Allen953/Baize_Q1mini/6.Education Files&PPT/PPT/6.IR RGB.pptx

## 机器人与人工智能实验室 Robotics and Artificial Intelligence Laboratory

Exciting Projects in RAIL CUHK-SZ

WELCOME TO

## RGB IR Controlling

- Change the three primary colours of the RBG light through the three buttons 1, 2, and 3 of the remote control, and press any other button to turn off the light.

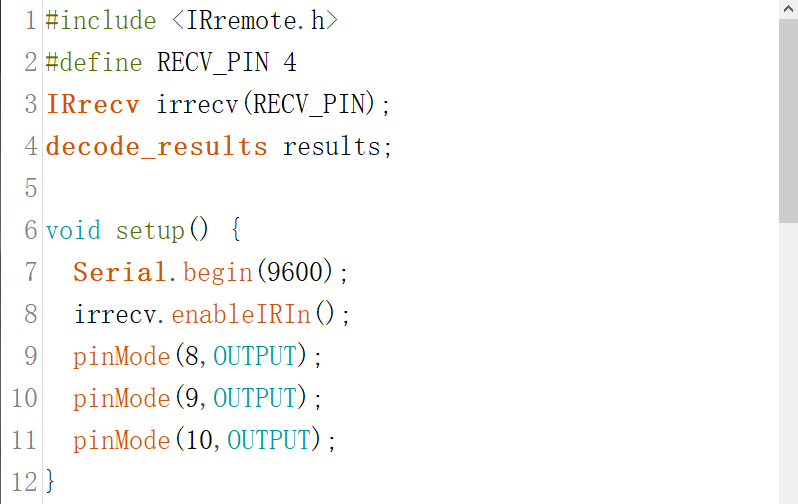
[picture p36: figure]

## RGB IR Controlling

- Next:

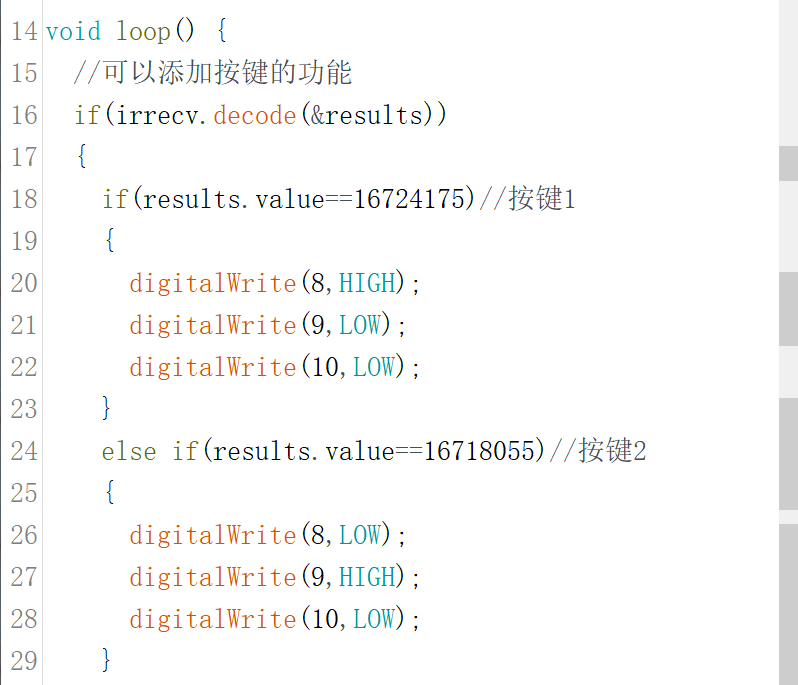
[picture p37: figure]

## RGB IR Controlling

- Next:

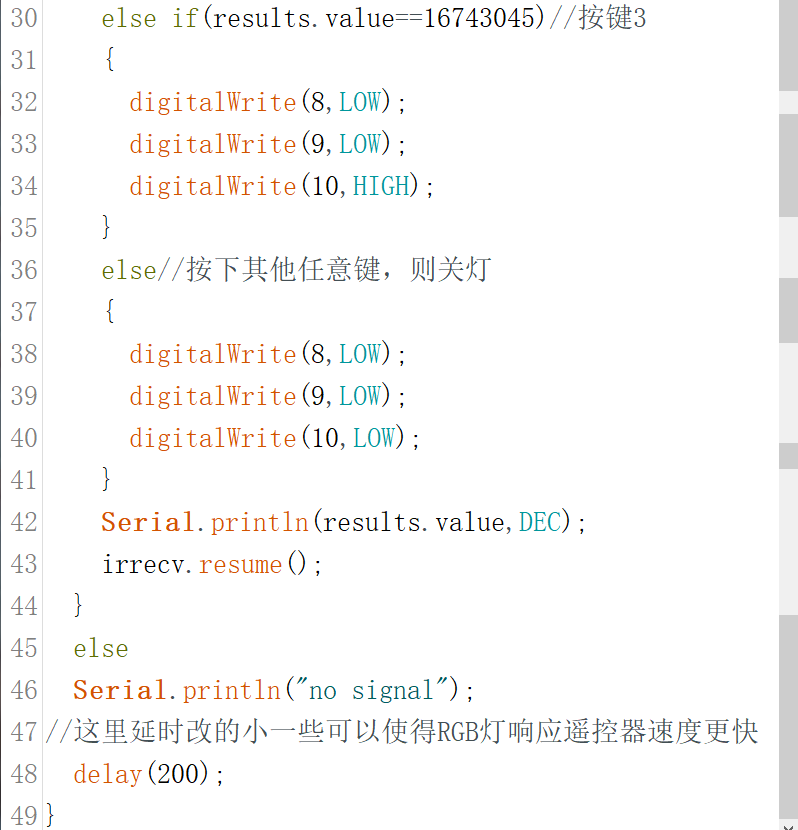
[picture p38: figure]

## THANK YOU

Teaching Building

- 林天麟 教授
- 香港中文大学（深圳）
- 机器人与人工智能实验室
- WeChat: tinlunlam
