Allen953/Baize_Q1mini/6.Education Files&PPT/PPT/AddNew.pptx

## 机器人与人工智能实验室 Robotics and Artificial Intelligence Laboratory

Exciting Projects in RAIL CUHK-SZ

WELCOME TO

## Adding New Instincts

- 1. Introduction
- Skills are the right fit between each steering engines.
- Skills can be divided into gait and posture according to the frame numbers, and the program also divides the skills into instinct (I) and new-skill (n).
- New-skills can be used as a test. When a new-skill is tested to be mature, it can be converted into a instinct.

## Adding New Instincts

- 2. Try to add a new posture called outstretch.
- 1. Code as the followings in instinct.h.
- 2. Add the name and type of the new skill.

## Adding New Instincts

- 3. Modify the skill number.
- 4. If the new skill performs well, it can be stored as a instinct (I) to reduce memory usage.

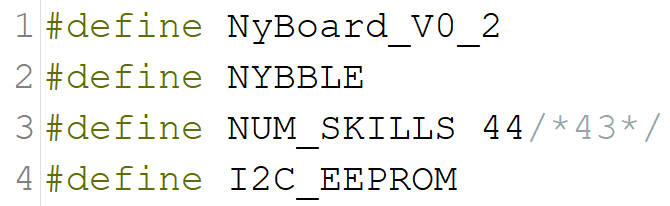
[picture p59: figure]

## THANK YOU

Teaching Building

- 林天麟 教授
- 香港中文大学（深圳）
- 机器人与人工智能实验室
- WeChat: tinlunlam
