Allen953/Baize_Q1mini/6.Education Files&PPT/PPT/Bluetooth.pptx

## 机器人与人工智能实验室 Robotics and Artificial Intelligence Laboratory

Exciting Projects in RAIL CUHK-SZ

WELCOME TO

## Control via Bluetooth

- 1. Preparation
- The Bluetooth module HC-05.
- The LED indicates the Bluetooth connection status:
- A fast flash----------No Bluetooth connection
- A slow flash---------The AT mode
- A double flash------Bluetooth connected and port opened

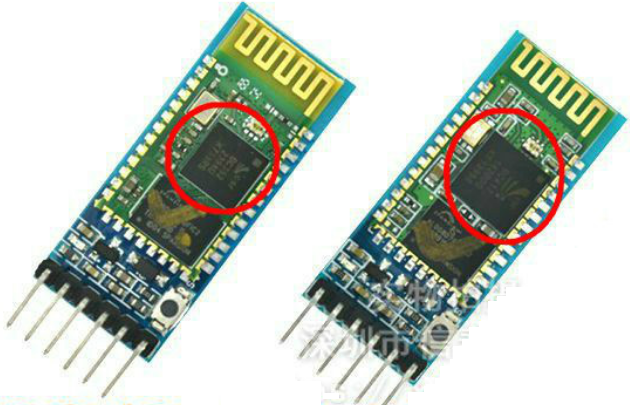
[picture p60: figure]

## Control via Bluetooth

- 2. Debugging
- AT mode (Next Slide)
- Serial port tool

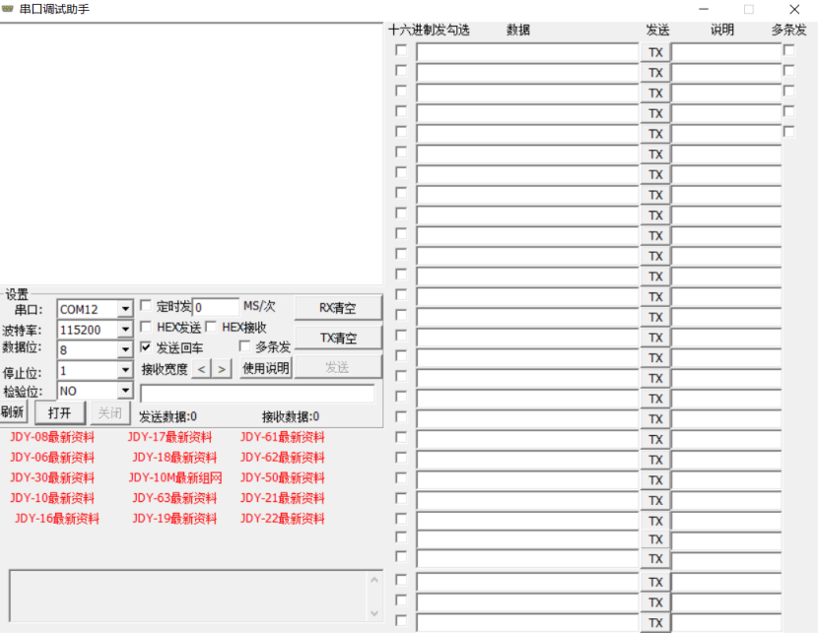
[picture p61: figure]
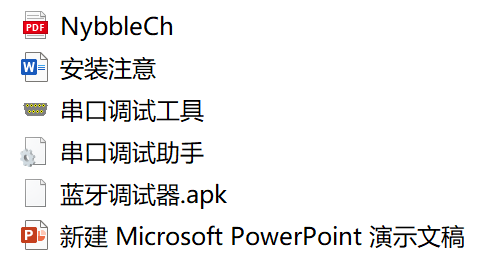
[picture p62: figure]

## Control via Bluetooth

- 3. Setting for AT Mode
- 1. Connect the FTDI downloader to the HC-05 module with a DuPont cable with bus-connectors on both sides.

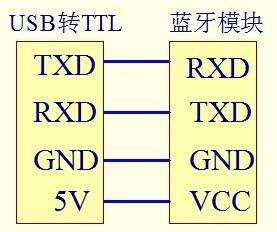
[picture p63: figure]

## Control via Bluetooth

- 2. Press and hold the black button on the module, and then power on, you can enter the AT mode.

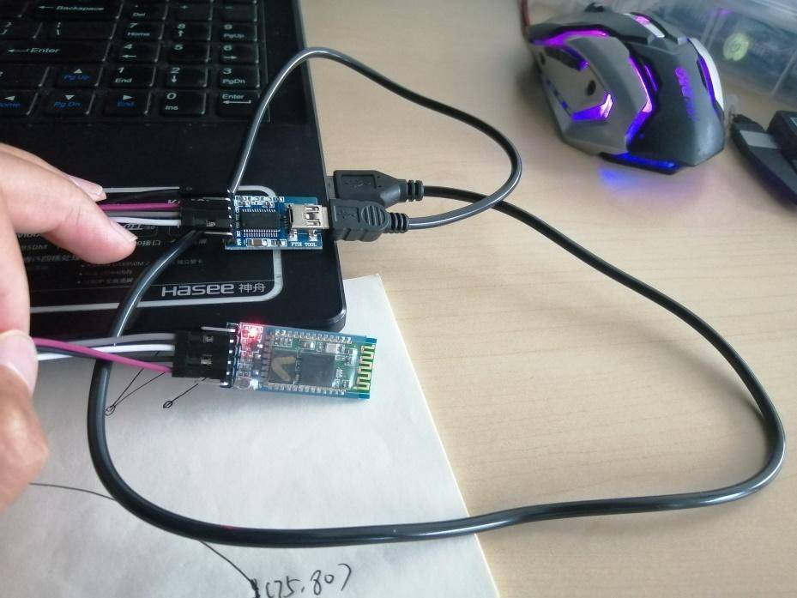
[picture p64: figure]

## Control via Bluetooth

- 3. Find the device manager to see which port Bluetooth is currently on.

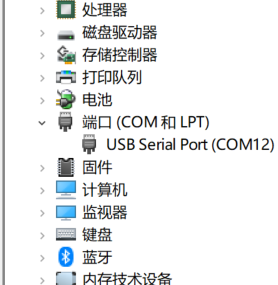
[picture p65: figure]

## Control via Bluetooth

- 4. Open the software and set as follows:
- (a) The baud rate (Customizable): 38400
- (b) Serial port: COM12
- (c) Check "Send Enter"
- Then click the "Open" button.
- Type in "AT" and the window returns OK. This shows that we have successfully entered the AT mode.

## Control via Bluetooth

- 5. Enter the following commands successively. For each line of instructions, click Send.
- (a) AT+NAME=Opencat9
- (b) AT+UART=57600,0,0
- (c) AT+ROLE=0
- Every time a command is sent, it will return OK if setting successfully. We can see that a total of three OK are returned, indicating that all settings are valid.

## Control via Bluetooth

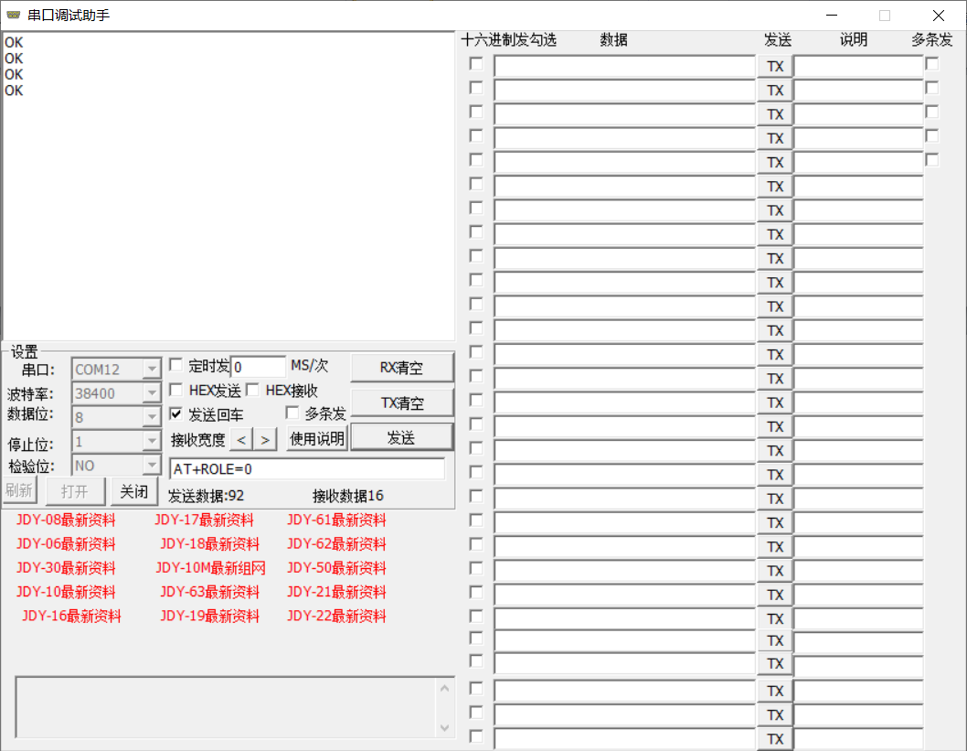
[picture p66: figure]

## Control via Bluetooth

- 4. Bluetooth Connecting
- 1. Installing Bluetooth Debugger
- P.S. APK provided:

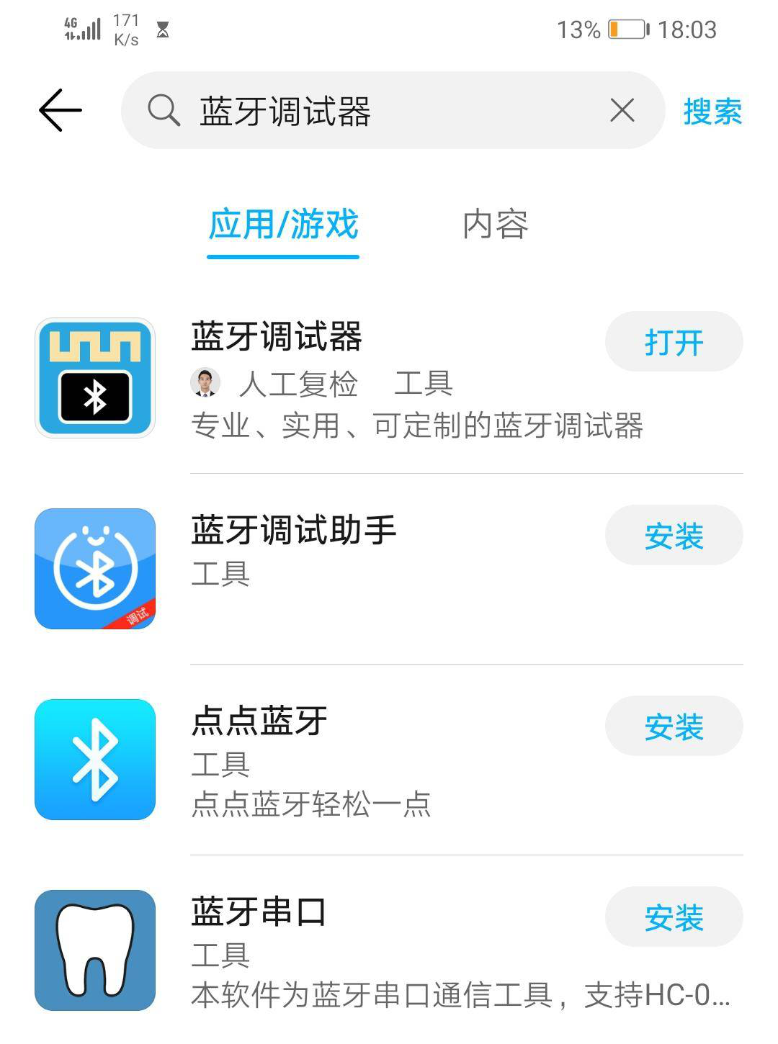
[picture p67: figure]
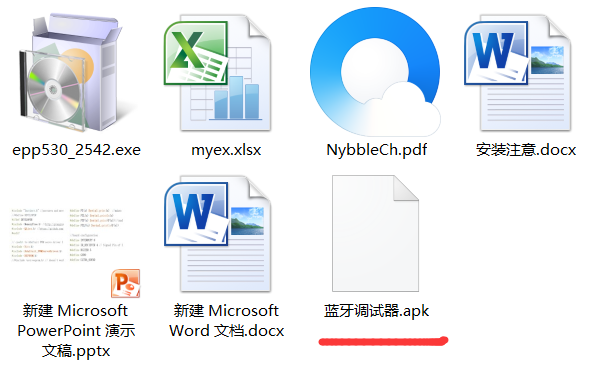
[picture p68: figure]

## Control via Bluetooth

- 2. Connecting with the APP
- Connect targets
- Scan available devices

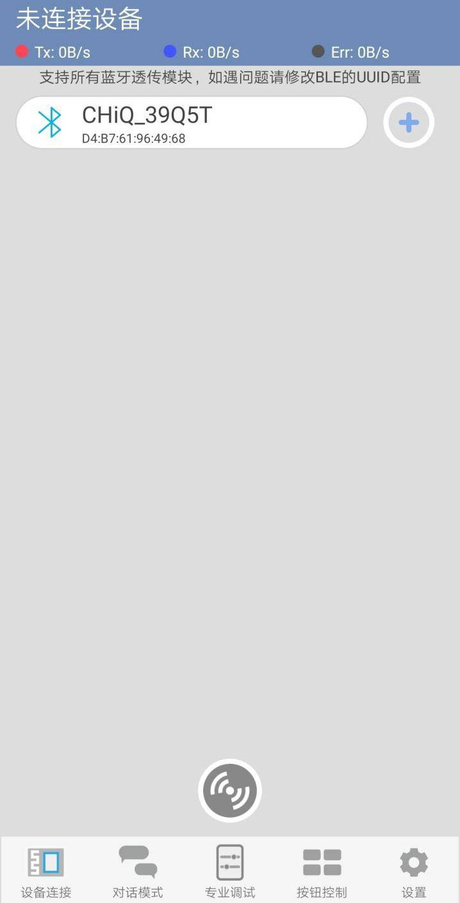
[picture p69: figure]

## Control via Bluetooth

- 3. Edit commands
- Detail:

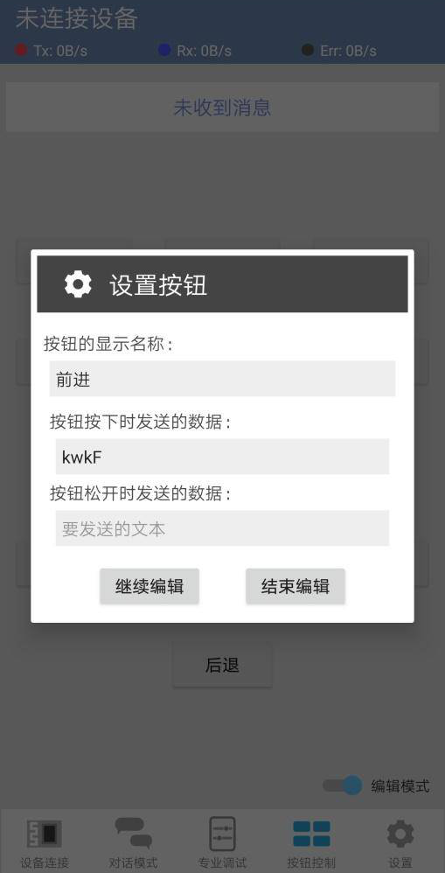
[picture p70: figure]
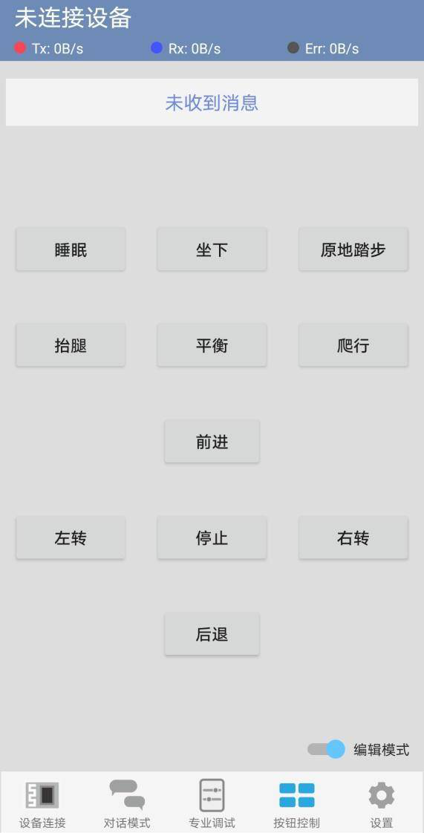
[picture p71: figure]

krest or d - Stopping steering engine
kbalance - Standing still
kwk - Walking forward
kwkL - Turning left
kwkR - Turning right
kbk - Retreating
ksleep - Sleeping
ksit - Sitting down
kvt - Stepping on the same spot
kpee - Peeing
Kcr - Crawling

## THANK YOU

Teaching Building

- 林天麟 教授
- 香港中文大学（深圳）
- 机器人与人工智能实验室
- WeChat: tinlunlam
