Allen953/Baize_Q1mini/1.3D model/Baize_QuadrupedRobot_3.0/readme.txt

板厚:3.0毫米
有激光切割零件，也有3D打印零件
所用的开发板底板为淘宝购买nano扩展板
