Allen953/Baize_Q1mini/1.3D model/Baize_QuadrupedRobot_Allboard/readme.txt

板厚:3.0毫米
全部零件都是板件切割
开发板底板用的是淘宝购买的nano扩展板
