Allen953/Baize_Q1mini/6.Education Files&PPT/PPT/Software.pptx

## 机器人与人工智能实验室 Robotics and Artificial Intelligence Laboratory

Exciting Projects in RAIL CUHK-SZ

WELCOME TO

## Tips on the Software

- 1. The Serial Monitor

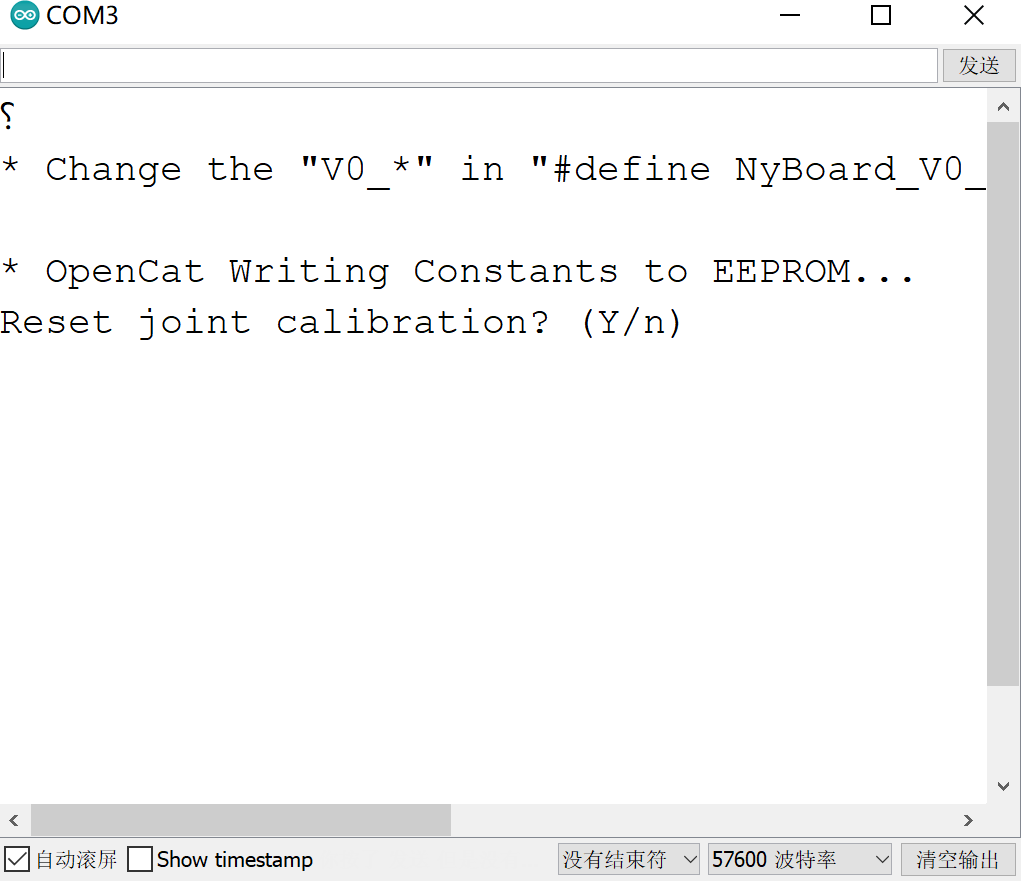
[picture p72: figure]

Significant for updating instincts of the cat!

Choose “No Line Ending” but Not “New Line”

## Tips on the Software

- The Serial Monitor

Only if No Line Ending is selected will the window shows the prompt for updating instincts.

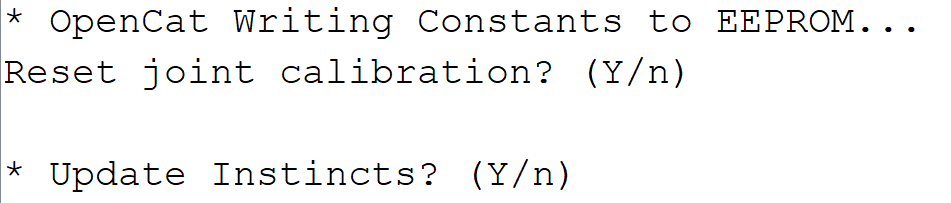
[picture p73: figure]

## THANK YOU

Teaching Building

- 林天麟 教授
- 香港中文大学（深圳）
- 机器人与人工智能实验室
- WeChat: tinlunlam
