Allen953/Baize_Q1mini/2.Hard ware(EasyEDA)/电路板文件/PCB_PCB_New Projec_2021-09-20.png

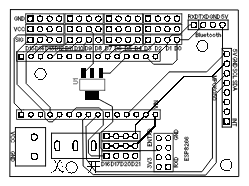
2.Hard ware(EasyEDA)/电路板文件/PCB_PCB_New Projec_2021-09-20.png
