Allen953/Baize_Q1mini/1.3D model/Baize_QuadrupedRobot_2.8/solidworks2020/MINIUSB - MEASURED.SLDASM

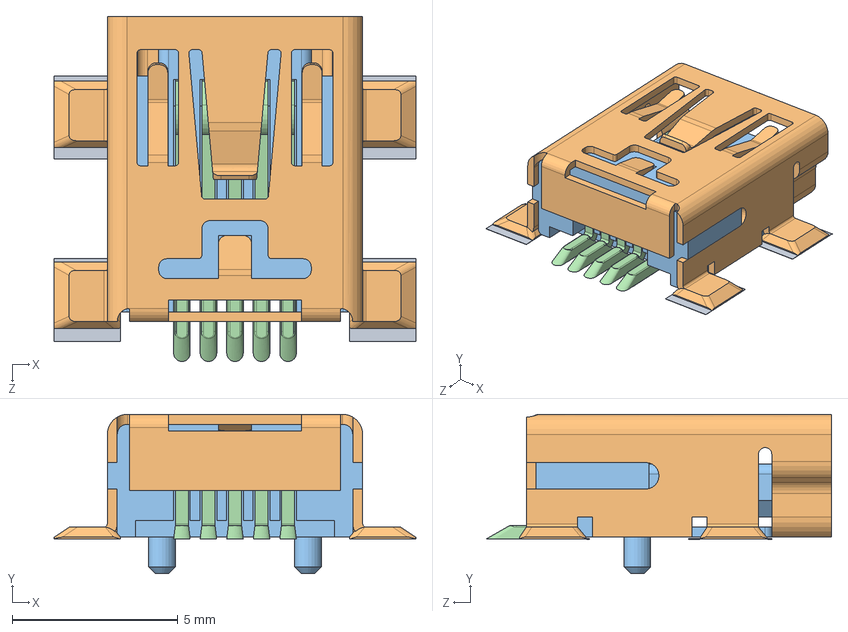
[picture p75: CAD file, 2022-08-04]
1.3D model/Baize_QuadrupedRobot_2.8/solidworks2020/MINIUSB - MEASURED.SLDASM
10.9 x 4.80 x 10.4 mm
MINIUSBSHELL
MINIUSBCORE
MINI USB CONTACT x 5
MINI USB SOLDER
