Allen953/Baize_Q1mini/1.3D model/Baize_QuadrupedRobot_2.8/solidworks2020/User Library-PJ-002AH.sldasm

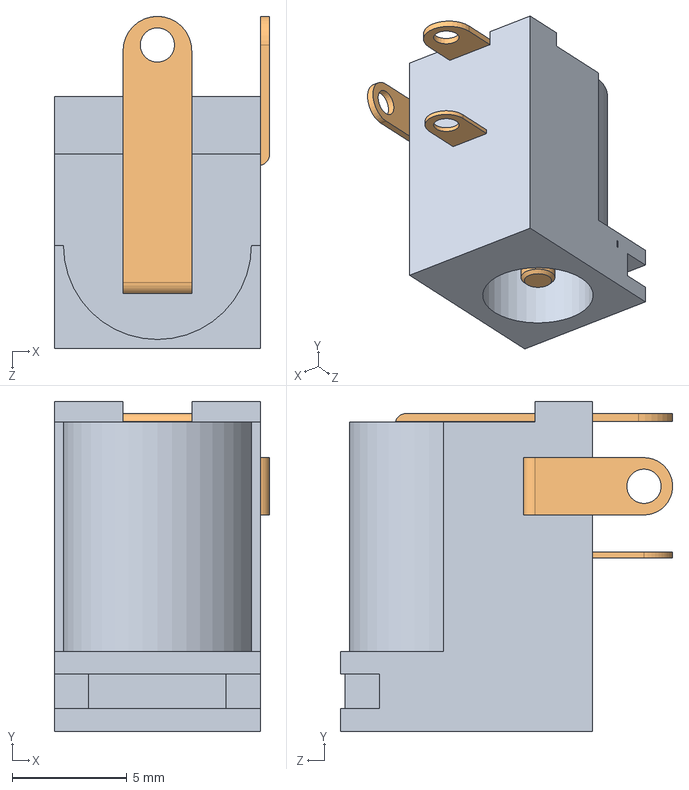
[picture p76: CAD file, 2022-08-04]
1.3D model/Baize_QuadrupedRobot_2.8/solidworks2020/User Library-PJ-002AH.sldasm
9.40 x 14.4 x 14.5 mm
User Library-PJ-002AH_Body
User Library-PJ-002AH_Pad
