Allen953/Baize_Q1mini/1.3D model/Baize_QuadrupedRobot_2.8/solidworks2020/SG90 - Micro Servo 9g - Tower Pro.SLDASM

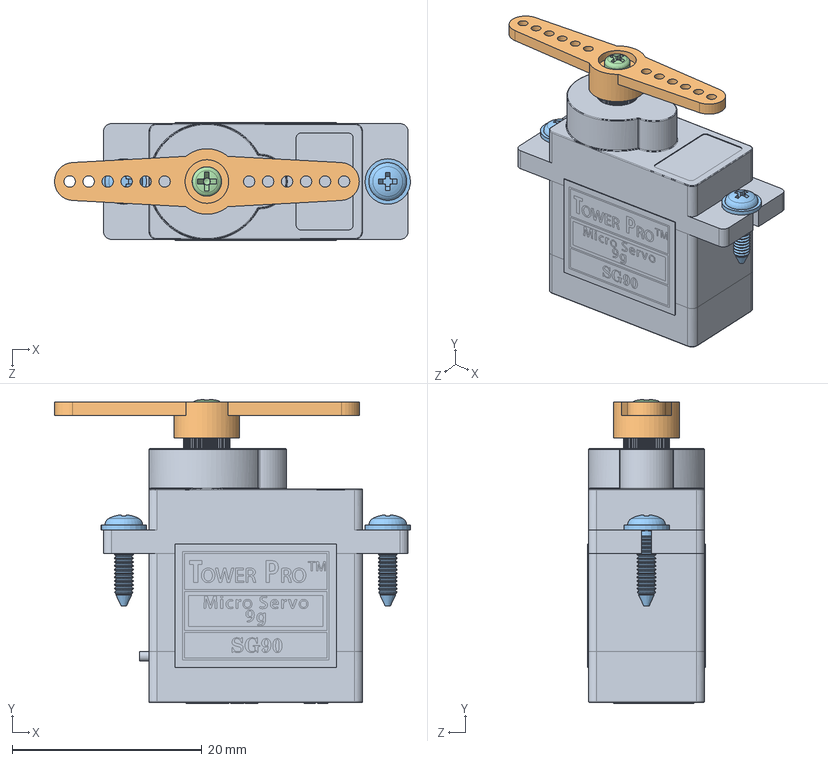
[picture p77: CAD file, 2022-08-04]
1.3D model/Baize_QuadrupedRobot_2.8/solidworks2020/SG90 - Micro Servo 9g - Tower Pro.SLDASM
37.5 x 32.0 x 12.4 mm
SG90 - Micro Servo 9g - Tower Pro.1
SG90 - Micro Servo 9g - Tower Pro.3
SG90 - Micro Servo 9g - Tower Pro.5 x 2
SG90 - Micro Servo 9g - Tower Pro.6
