Allen953/Baize_Q1mini/1.3D model/Baize_QuadrupedRobot_Allboard/Gou-2-Xiaotui2.SLDASM

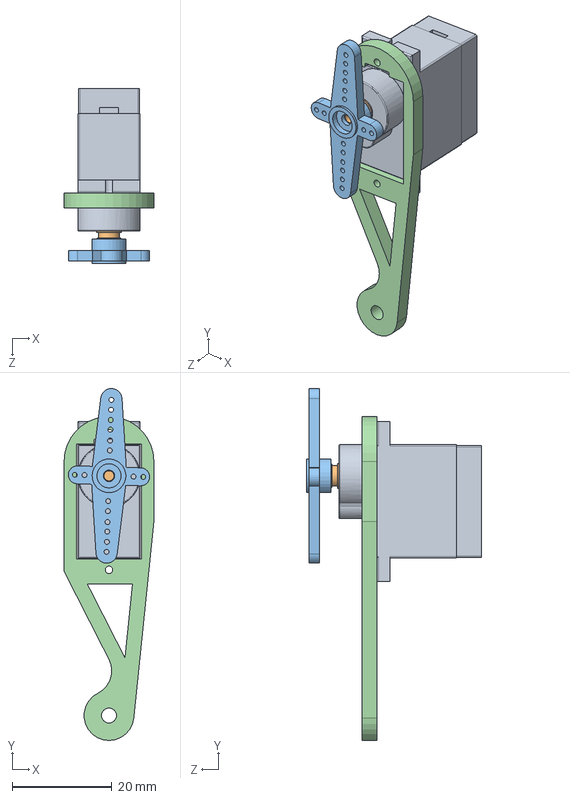
[picture p78: CAD file, 2022-08-04]
1.3D model/Baize_QuadrupedRobot_Allboard/Gou-2-Xiaotui2.SLDASM
18.0 x 70.5 x 35.0 mm
MG90servo_body
MG90servo_shaft
gou2-xiaotui
