Allen953/Baize_Q1mini/1.3D model/Baize_QuadrupedRobot_Allboard/arduino nano.SLDASM

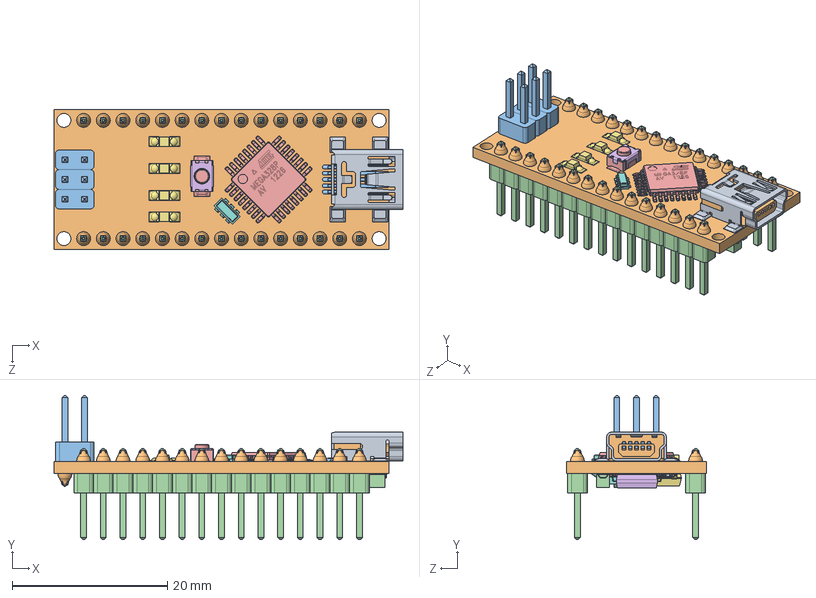
[picture p80: CAD file, 2022-08-04]
1.3D model/Baize_QuadrupedRobot_Allboard/arduino nano.SLDASM
45.0 x 18.6 x 18.0 mm
nano-board
2pin_header__02 x 3
15pin_header__ x 2
atmega328
ftdi FT232rl
led x 4
16mhz crystal - measured
MINIUSBSHELL
MINIUSBCORE
MINI USB CONTACT x 5
MINI USB SOLDER
cap106C x 2
reset core
reset shell
nano - reg
NANO DIODE
189 RESISTOR PACK
102 RESISTOR PACK
