Allen953/Baize_Q1mini/1.3D model/Baize_QuadrupedRobot_2.8/solidworks2020/Gou-2-Xiaotui.SLDASM

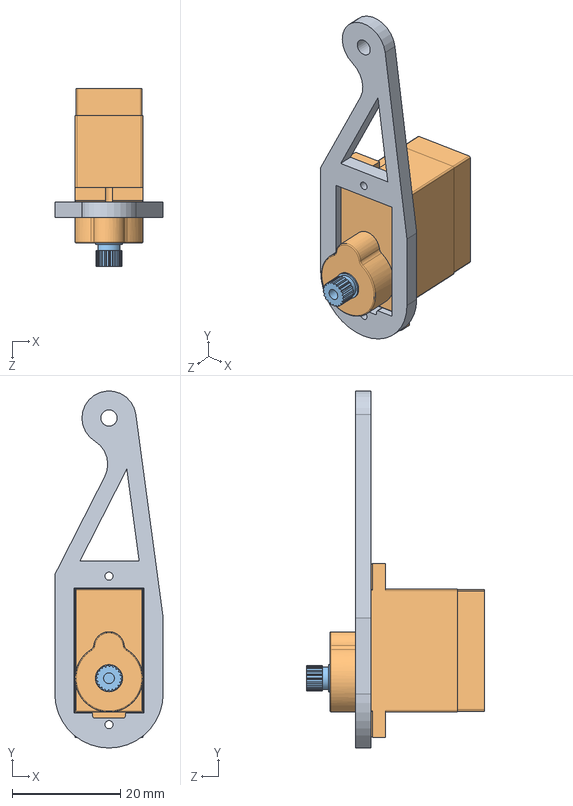
[picture p81: CAD file, 2022-08-04]
1.3D model/Baize_QuadrupedRobot_2.8/solidworks2020/Gou-2-Xiaotui.SLDASM
20.0 x 65.9 x 32.8 mm
gou2-xiaotui
MG90servo_body
MG90servo_shaft
