Allen953/Baize_Q1mini/1.3D model/Baize_QuadrupedRobot_3.0/reset button.SLDASM

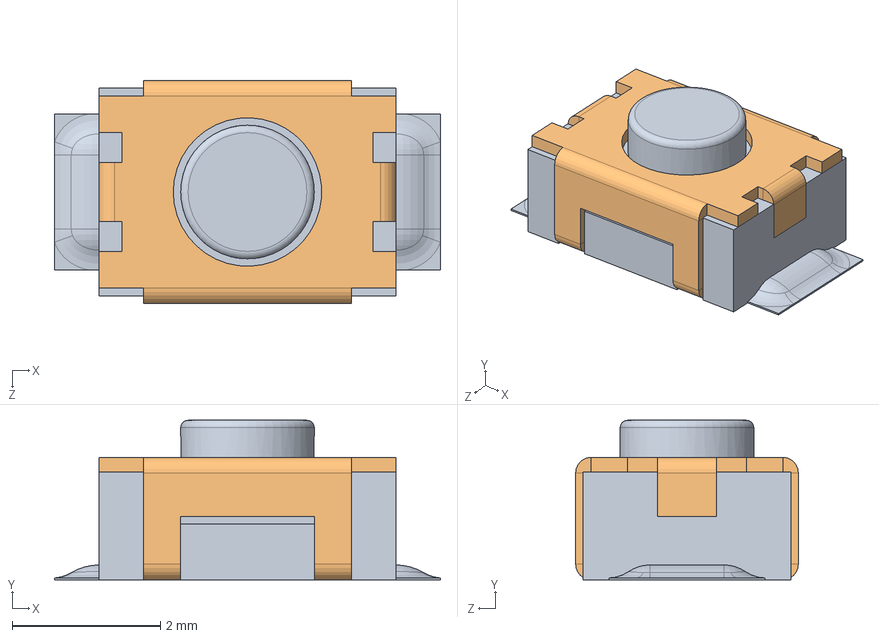
[picture p83: CAD file, 2022-08-04]
1.3D model/Baize_QuadrupedRobot_3.0/reset button.SLDASM
5.20 x 2.15 x 3.00 mm
reset core
reset shell
