Allen953/Baize_Q1mini/1.3D model/Baize_QuadrupedRobot_Allboard/Gou-2-Datui.SLDASM

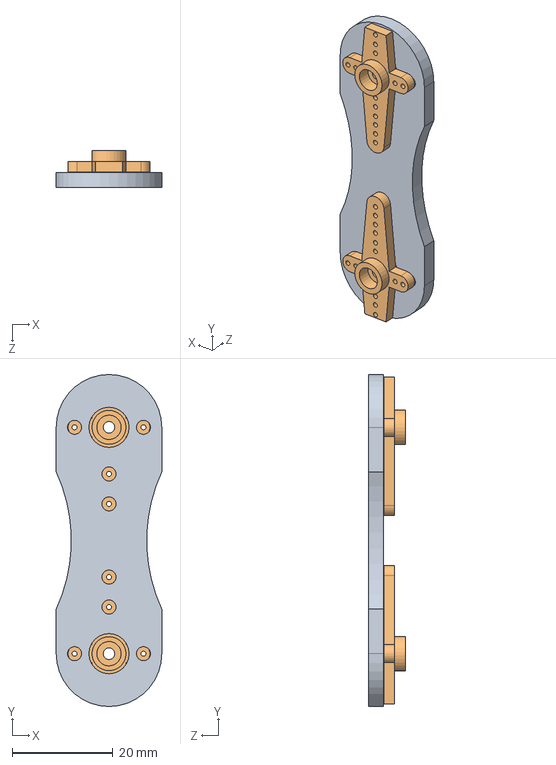
[picture p84: CAD file, 2022-08-04]
1.3D model/Baize_QuadrupedRobot_Allboard/Gou-2-Datui.SLDASM
21.0 x 66.0 x 7.45 mm
Thigh
MG90servo_gear-2 x 2
