Allen953/Baize_Q1mini/1.3D model/Baize_QuadrupedRobot_3.0/MG90servo_assembly.SLDASM

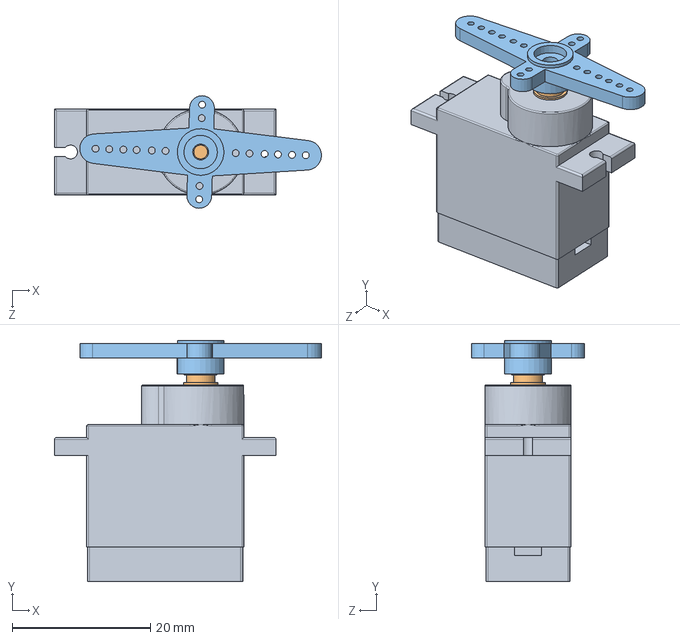
[picture p85: CAD file, 2022-08-04]
1.3D model/Baize_QuadrupedRobot_3.0/MG90servo_assembly.SLDASM
38.6 x 35.0 x 16.3 mm
MG90servo_body
MG90servo_shaft
