Allen953/Baize_Q1mini/1.3D model/Baize_QuadrupedRobot_2.8/solidworks2020/Gou-2-Xiaotui2.SLDASM

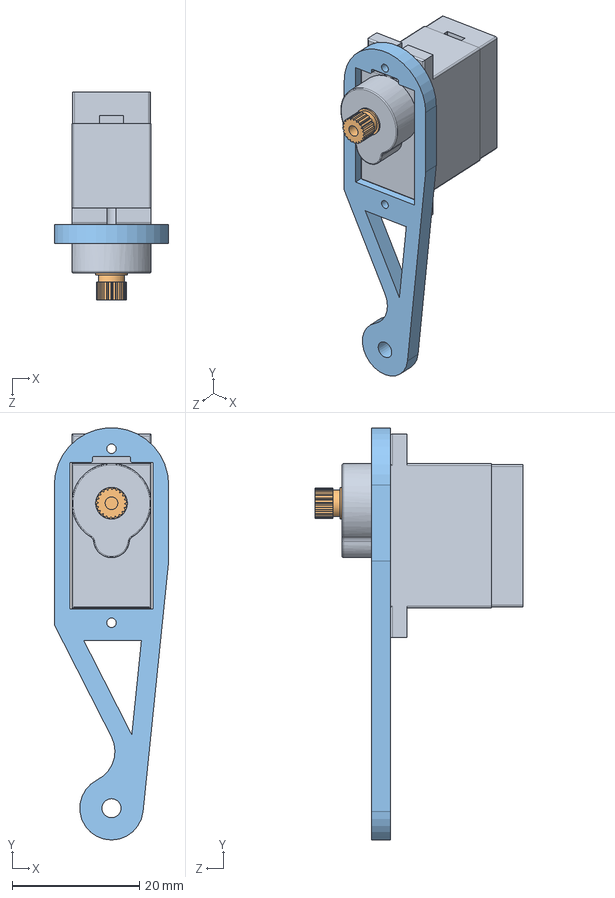
[picture p87: CAD file, 2022-08-04]
1.3D model/Baize_QuadrupedRobot_2.8/solidworks2020/Gou-2-Xiaotui2.SLDASM
18.0 x 64.8 x 32.8 mm
MG90servo_body
MG90servo_shaft
gou2-xiaotui
