Allen953/Baize_Q1mini/1.3D model/Baize_QuadrupedRobot_2.8/solidworks2020/MG90servo_assembly.SLDASM

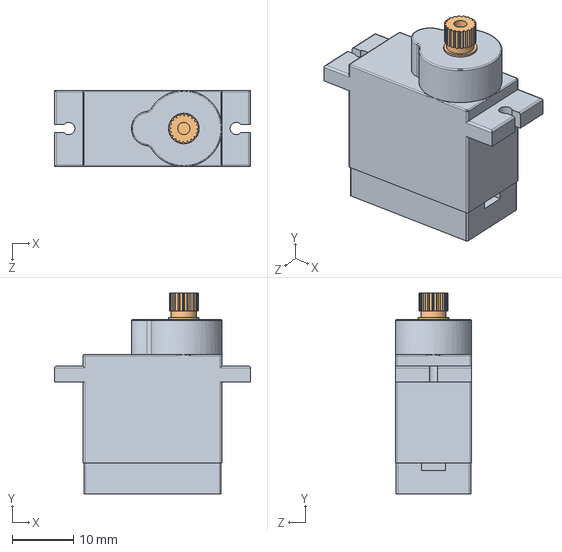
[picture p89: CAD file, 2022-08-04]
1.3D model/Baize_QuadrupedRobot_2.8/solidworks2020/MG90servo_assembly.SLDASM
32.0 x 32.8 x 12.5 mm
MG90servo_body
MG90servo_shaft
