Allen953/Baize_Q1mini/1.3D model/Baize_QuadrupedRobot_2.8/solidworks2020/mpu6050.SLDASM

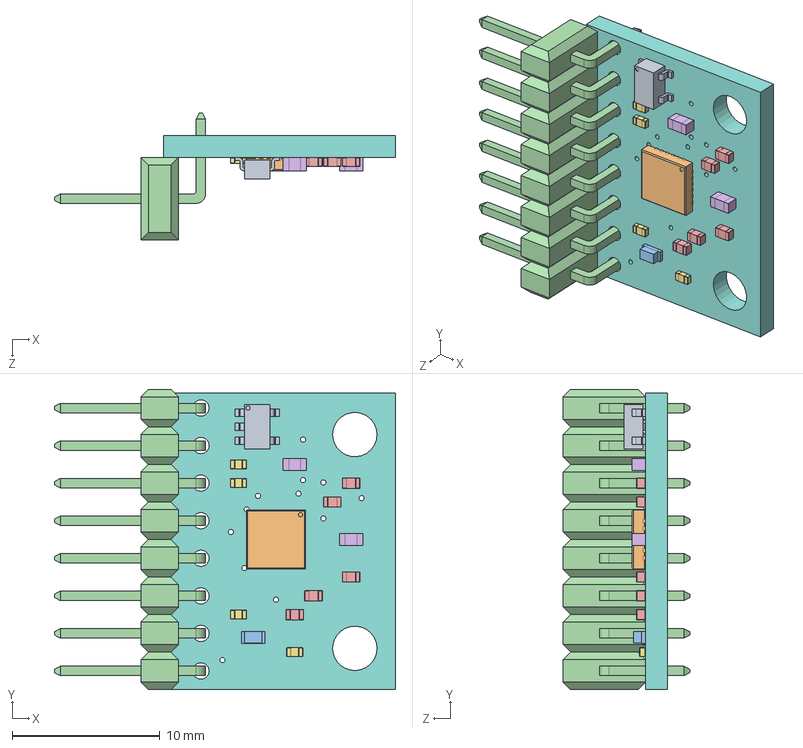
[picture p90: CAD file, 2022-08-04]
1.3D model/Baize_QuadrupedRobot_2.8/solidworks2020/mpu6050.SLDASM
23.1 x 20.3 x 8.56 mm
SOT95P295X145-5N.stp
QFN50P395X395X90-25T265X255N.stp
CHIP-LED0603.stp
HDRRA8W64P254_1X8_2032X254X556B.stp
C0402.stp x 5
C0603.stp x 2
R0402.stp x 4
Board.stp
