Allen953/Baize_Q1mini/1.3D model/Baize_QuadrupedRobot_2.8/solidworks2020/JIJIA.SLDASM

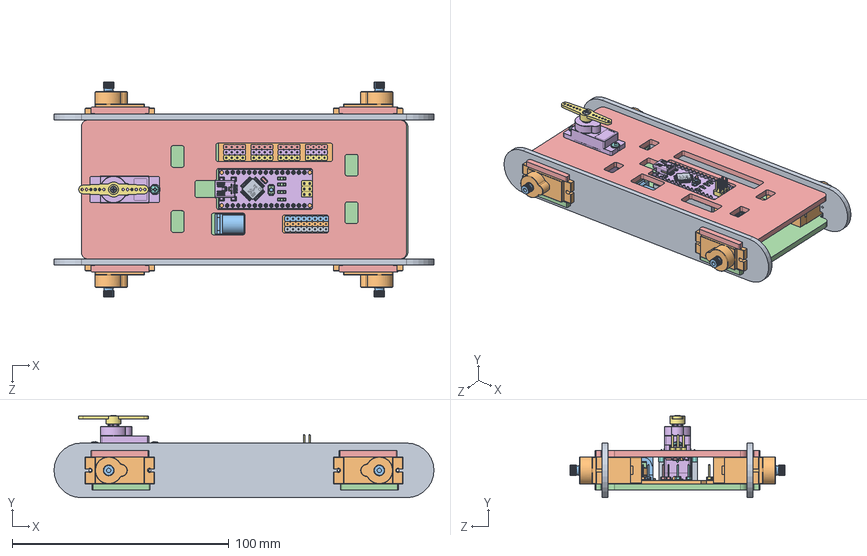
[picture p91: CAD file, 2022-08-04]
1.3D model/Baize_QuadrupedRobot_2.8/solidworks2020/JIJIA.SLDASM
175.2 x 38.0 x 98.9 mm
Ceban_gou x 2
MG90servo_body x 4
MG90servo_shaft x 4
Diban-g
Diban-g-s
SG90 - Micro Servo 9g - Tower Pro.1
SG90 - Micro Servo 9g - Tower Pro.3
SG90 - Micro Servo 9g - Tower Pro.5 x 2
SG90 - Micro Servo 9g - Tower Pro.6
Shield_Arduino NANO
User Library-PJ-002AH_Body
User Library-PJ-002AH_Pad
Samtec-TLW-103-01-F-S x 2
nano-board
2pin_header__02 x 3
15pin_header__ x 2
atmega328
ftdi FT232rl
smt_resistor222_a x 8
led x 5
16mhz crystal - measured
MINIUSBSHELL
MINIUSBCORE
MINI USB CONTACT x 5
MINI USB SOLDER
cap106C x 4
reset core x 2
reset shell x 2
nano - reg x 2
NANO DIODE
189 RESISTOR PACK
102 RESISTOR PACK
Samtec-SSW-115-01-F-S x 2
47uf CAP Dcase
m7 diode
blm21
Samtec-TLW-104-01-F-S_N x 4
Samtec-TLW-104-01-F-S_R x 4
Samtec-TLW-104-01-F-S_B x 4
Samtec-TLW-104-01-F-S_W x 2
Samtec-TLW-108-01-F-S_B
Samtec-TLW-108-01-F-S_R
Samtec-TLW-108-01-F-S_N
