Allen953/Baize_Q1mini/1.3D model/Baize_QuadrupedRobot_3.0/47uf CAP Dcase.SLDPRT

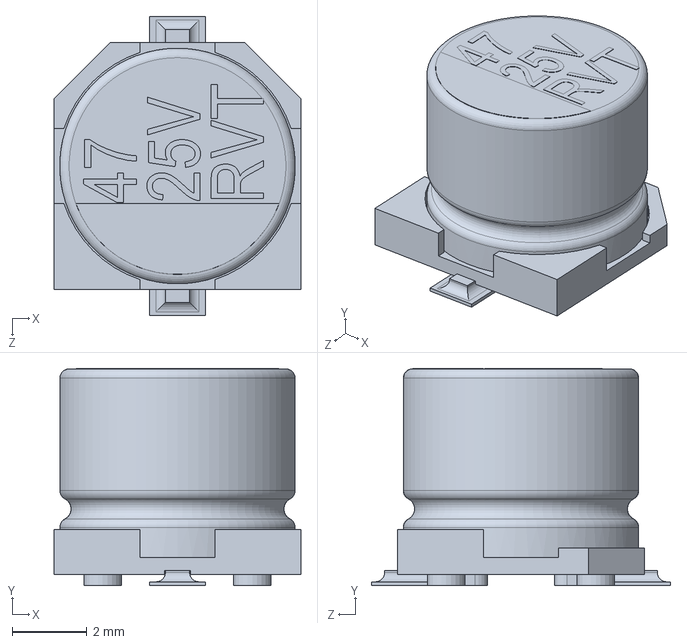
[picture p92: CAD file, 2022-08-04]
1.3D model/Baize_QuadrupedRobot_3.0/47uf CAP Dcase.SLDPRT
6.60 x 5.81 x 8.00 mm
