Allen953/Baize_Q1mini/1.3D model/Baize_QuadrupedRobot_Allboard/Samtec-TLW-104-01-F-S_N.SLDPRT

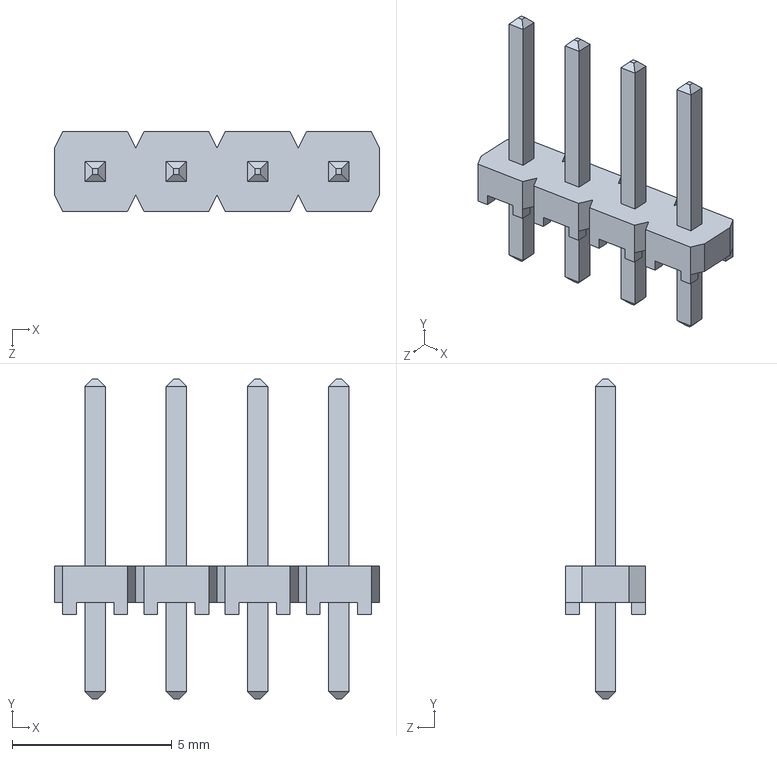
[picture p93: CAD file, 2022-08-04]
1.3D model/Baize_QuadrupedRobot_Allboard/Samtec-TLW-104-01-F-S_N.SLDPRT
10.2 x 10.0 x 2.49 mm
