Allen953/Baize_Q1mini/2.Hard ware(EasyEDA)/电路板文件/OBJ_PCB_New Projec_2021-09-20/OBJ_PCB_New Projec.obj

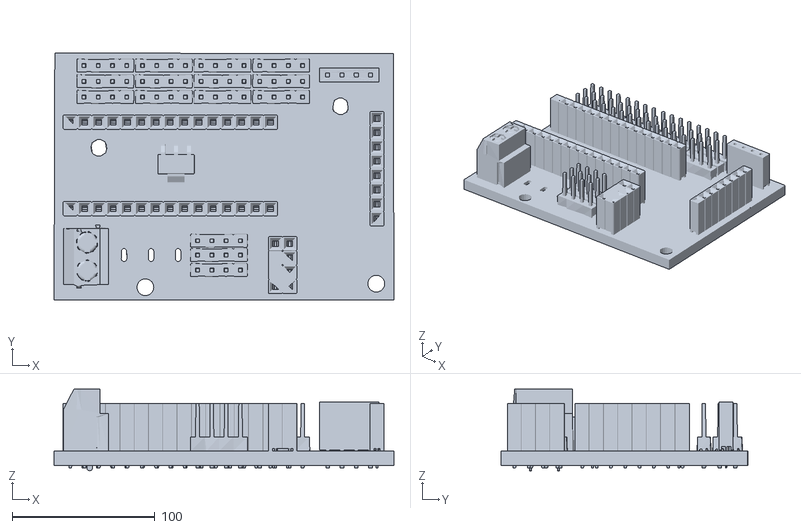
[picture p94: CAD file, 2022-08-04]
2.Hard ware(EasyEDA)/电路板文件/OBJ_PCB_New Projec_2021-09-20/OBJ_PCB_New Projec.obj
237.8 x 172.7 x 57.1
