Allen953/Baize_Q1mini/1.3D model/Baize_QuadrupedRobot_Allboard/16mhz crystal - measured.SLDPRT

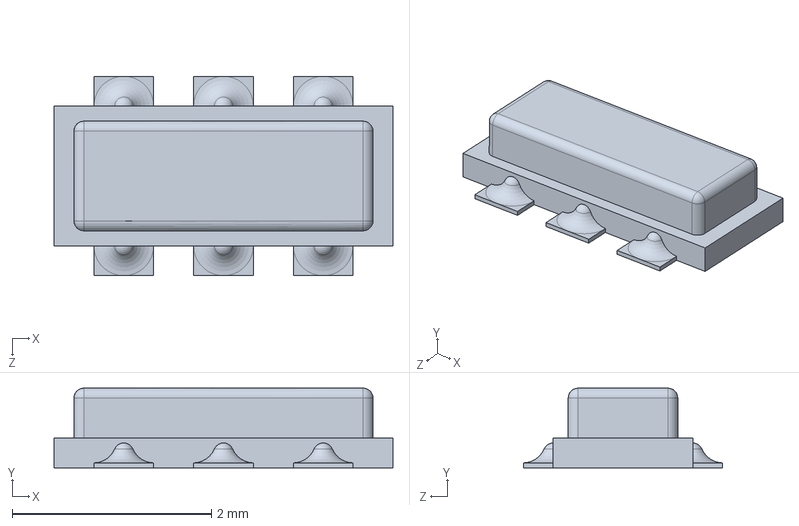
[picture p95: CAD file, 2022-08-04]
1.3D model/Baize_QuadrupedRobot_Allboard/16mhz crystal - measured.SLDPRT
3.40 x 0.8 x 2.00 mm
