Allen953/Baize_Q1mini/1.3D model/Baize_QuadrupedRobot_2.8/solidworks2020/102 RESISTOR PACK.SLDPRT

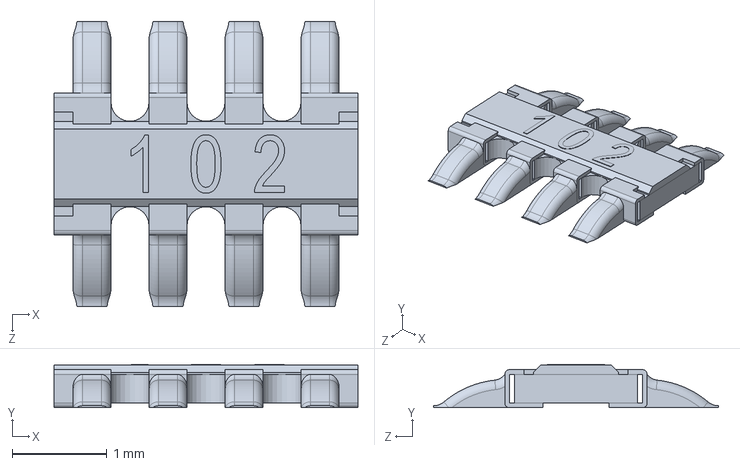
[picture p96: CAD file, 2022-08-04]
1.3D model/Baize_QuadrupedRobot_2.8/solidworks2020/102 RESISTOR PACK.SLDPRT
3.20 x 0.455 x 3.00 mm
