Allen953/Baize_Q1mini/1.3D model/Baize_QuadrupedRobot_2.8/solidworks2020/SG90 - Micro Servo 9g - Tower Pro.4.SLDPRT

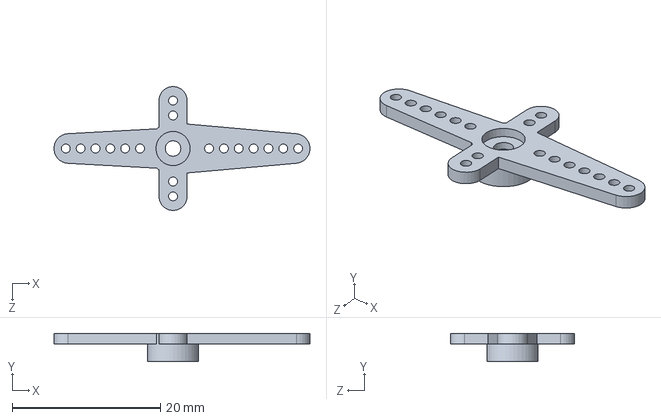
[picture p97: CAD file, 2022-08-04]
1.3D model/Baize_QuadrupedRobot_2.8/solidworks2020/SG90 - Micro Servo 9g - Tower Pro.4.SLDPRT
34.5 x 3.80 x 16.7 mm
