Allen953/Baize_Q1mini/1.3D model/Baize_QuadrupedRobot_3.0/m7 diode.SLDPRT

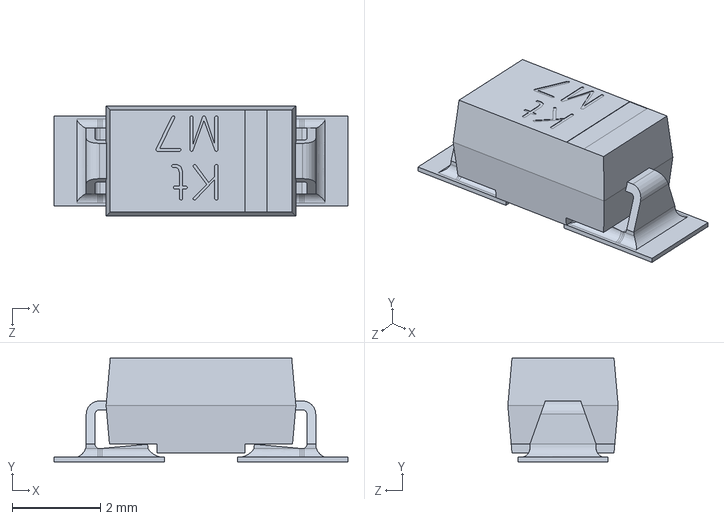
[picture p98: CAD file, 2022-08-04]
1.3D model/Baize_QuadrupedRobot_3.0/m7 diode.SLDPRT
6.66 x 2.35 x 2.50 mm
