Allen953/Baize_Q1mini/1.3D model/Baize_QuadrupedRobot_Allboard/Samtec-TLW-103-01-F-S.SLDPRT

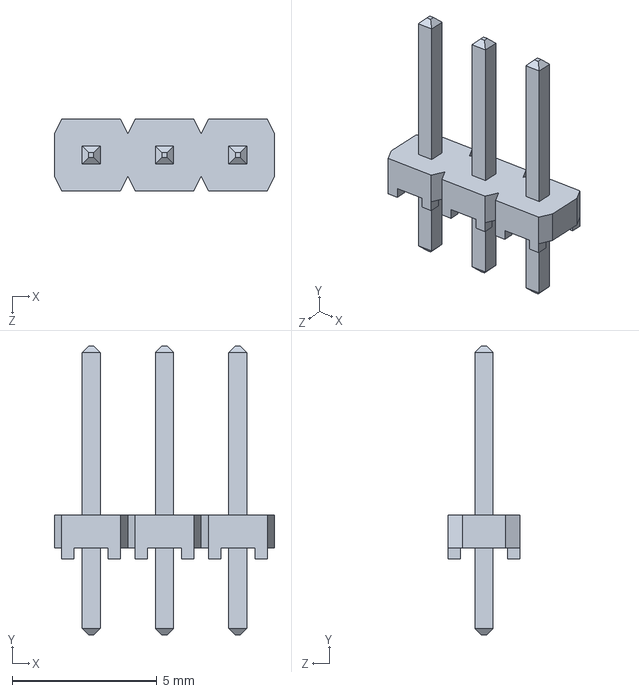
[picture p99: CAD file, 2022-08-04]
1.3D model/Baize_QuadrupedRobot_Allboard/Samtec-TLW-103-01-F-S.SLDPRT
7.62 x 10.0 x 2.49 mm
