Allen953/Baize_Q1mini/1.3D model/Baize_QuadrupedRobot_3.0/MINI USB SOLDER.SLDPRT

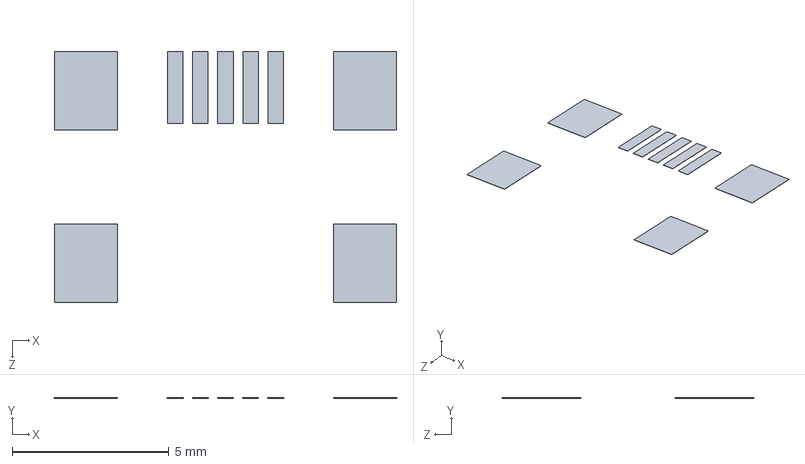
[picture p100: CAD file, 2022-08-04]
1.3D model/Baize_QuadrupedRobot_3.0/MINI USB SOLDER.SLDPRT
10.9 x 0.01 x 8.00 mm
