Allen953/Baize_Q1mini/1.3D model/Baize_QuadrupedRobot_Allboard/MG90servo_body.SLDPRT

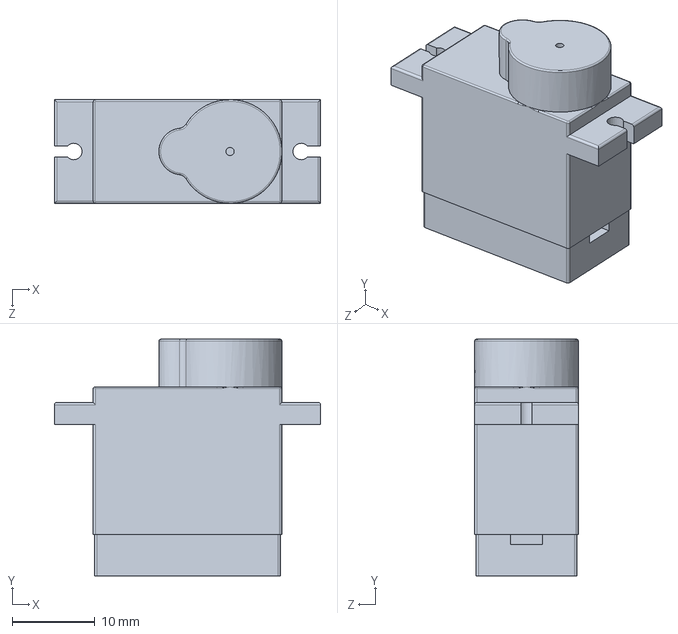
[picture p101: CAD file, 2022-08-04]
1.3D model/Baize_QuadrupedRobot_Allboard/MG90servo_body.SLDPRT
32.0 x 28.5 x 12.5 mm
