Allen953/Baize_Q1mini/1.3D model/Baize_QuadrupedRobot_2.8/solidworks2020/atmega328.SLDPRT

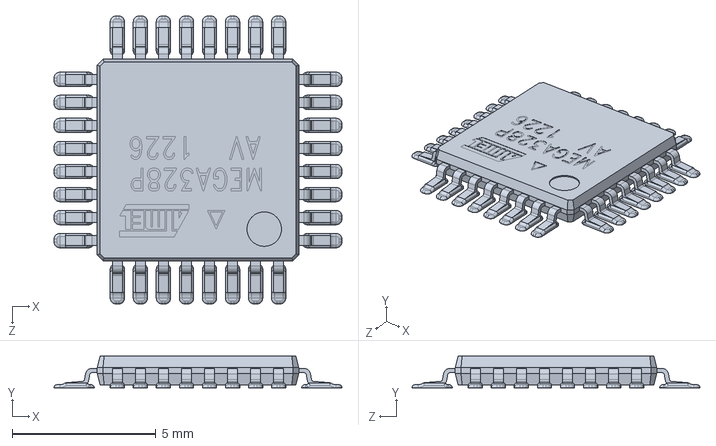
[picture p102: CAD file, 2022-08-04]
1.3D model/Baize_QuadrupedRobot_2.8/solidworks2020/atmega328.SLDPRT
10.0 x 1.10 x 10.0 mm
