Allen953/Baize_Q1mini/1.3D model/Baize_QuadrupedRobot_Allboard/SG90 - Micro Servo 9g - Tower Pro.5.SLDPRT

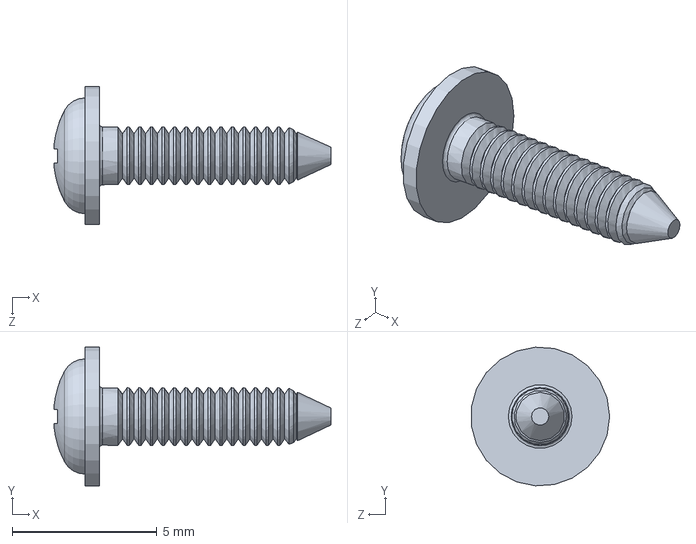
[picture p103: CAD file, 2022-08-04]
1.3D model/Baize_QuadrupedRobot_Allboard/SG90 - Micro Servo 9g - Tower Pro.5.SLDPRT
9.57 x 4.79 x 4.78 mm
