Allen953/Baize_Q1mini/1.3D model/Baize_QuadrupedRobot_2.8/solidworks2020/nano-board.SLDPRT

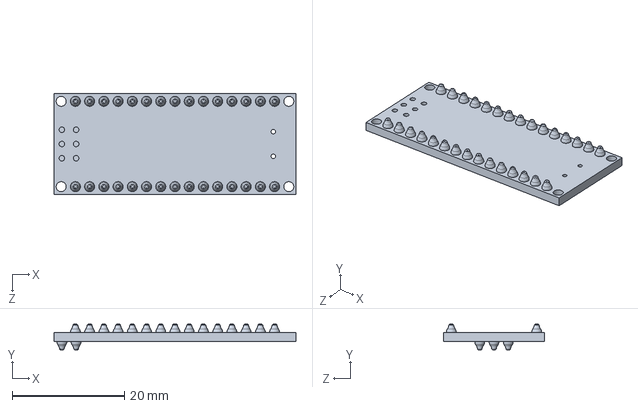
[picture p104: CAD file, 2022-08-04]
1.3D model/Baize_QuadrupedRobot_2.8/solidworks2020/nano-board.SLDPRT
43.2 x 4.60 x 18.0 mm
