Allen953/Baize_Q1mini/1.3D model/Baize_QuadrupedRobot_3.0/Samtec-TLW-108-01-F-S_B.SLDPRT

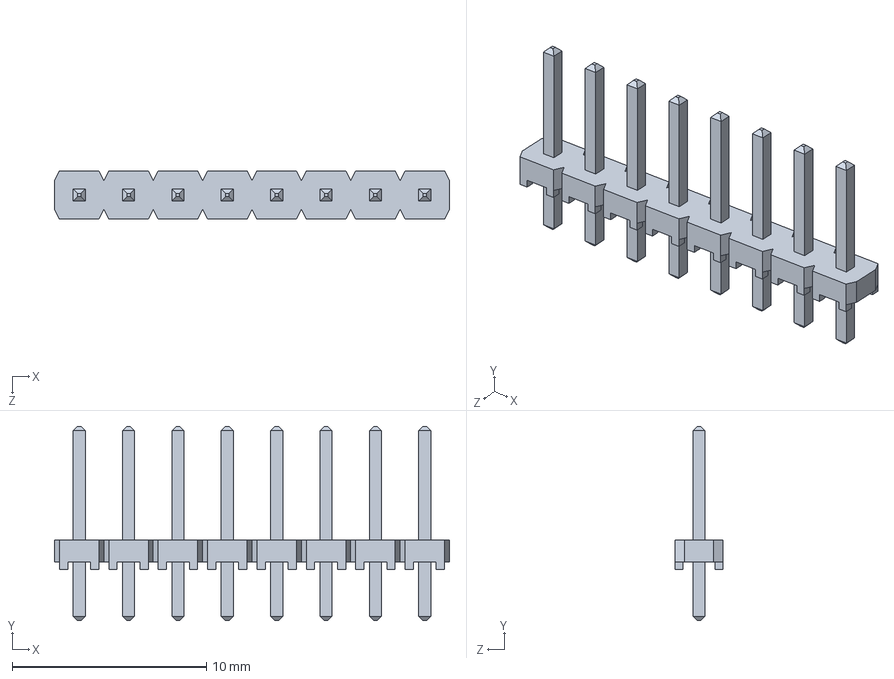
[picture p105: CAD file, 2022-08-04]
1.3D model/Baize_QuadrupedRobot_3.0/Samtec-TLW-108-01-F-S_B.SLDPRT
20.3 x 10.0 x 2.49 mm
