Allen953/Baize_Q1mini/1.3D model/Baize_QuadrupedRobot_2.8/solidworks2020/Thigh.SLDPRT

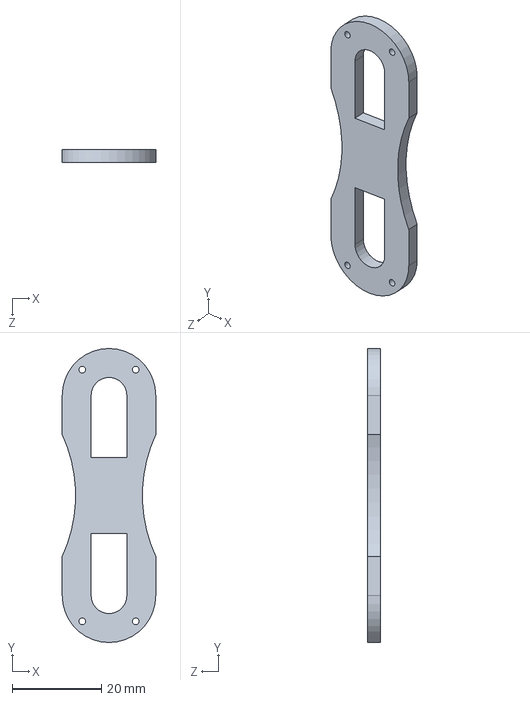
[picture p106: CAD file, 2022-08-04]
1.3D model/Baize_QuadrupedRobot_2.8/solidworks2020/Thigh.SLDPRT
21.0 x 66.0 x 2.90 mm
