Allen953/Baize_Q1mini/1.3D model/Baize_QuadrupedRobot_3.0/MINIUSBCORE.SLDPRT

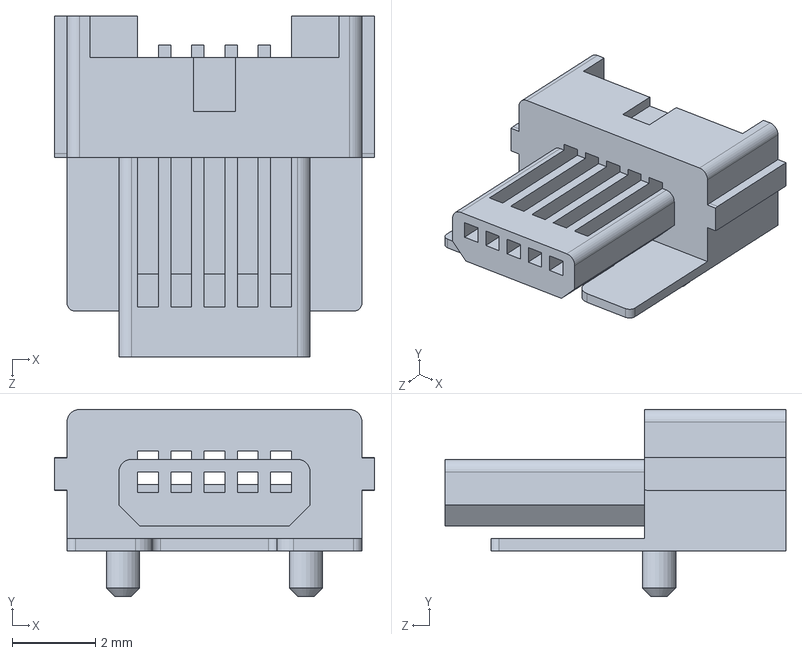
[picture p107: CAD file, 2022-08-04]
1.3D model/Baize_QuadrupedRobot_3.0/MINIUSBCORE.SLDPRT
7.70 x 4.50 x 8.20 mm
