Allen953/Baize_Q1mini/1.3D model/Baize_QuadrupedRobot_2.8/solidworks2020/blm21.SLDPRT

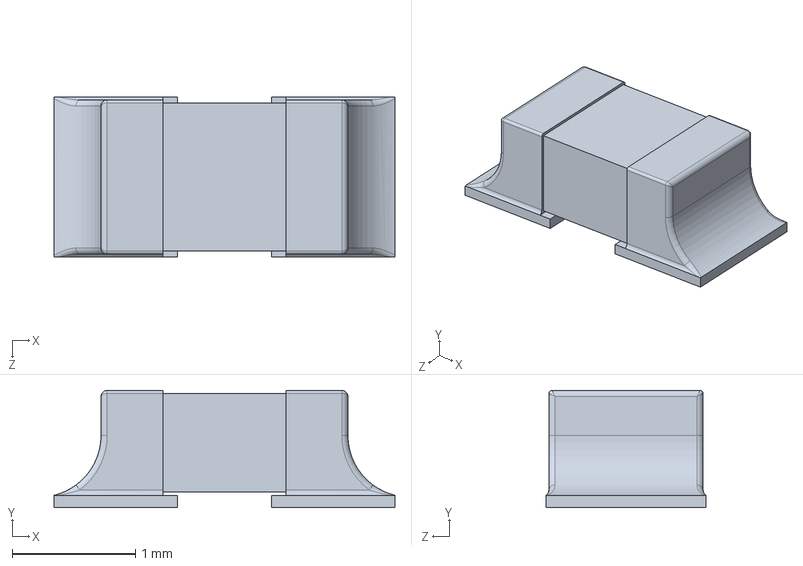
[picture p108: CAD file, 2022-08-04]
1.3D model/Baize_QuadrupedRobot_2.8/solidworks2020/blm21.SLDPRT
2.76 x 0.95 x 1.30 mm
