Allen953/Baize_Q1mini/1.3D model/Baize_QuadrupedRobot_2.8/solidworks2020/Diban-g.SLDPRT

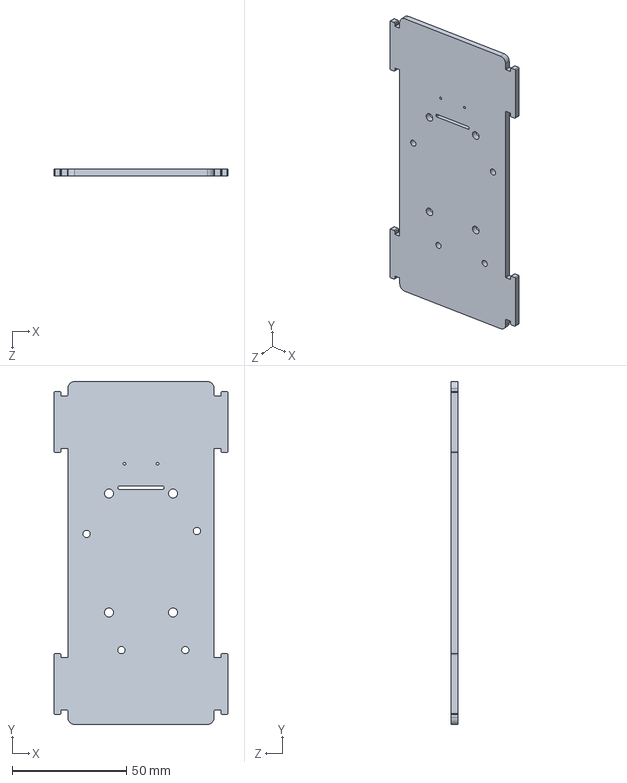
[picture p109: CAD file, 2022-08-04]
1.3D model/Baize_QuadrupedRobot_2.8/solidworks2020/Diban-g.SLDPRT
76.0 x 150.0 x 2.90 mm
