Allen953/Baize_Q1mini/1.3D model/Baize_QuadrupedRobot_Allboard/SG90 - Micro Servo 9g - Tower Pro.2.SLDPRT

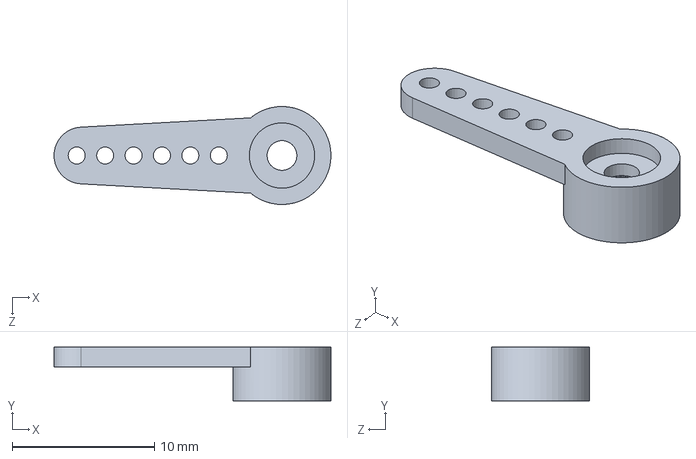
[picture p110: CAD file, 2022-08-04]
1.3D model/Baize_QuadrupedRobot_Allboard/SG90 - Micro Servo 9g - Tower Pro.2.SLDPRT
19.5 x 3.80 x 6.90 mm
