Allen953/Baize_Q1mini/1.3D model/Baize_QuadrupedRobot_Allboard/MG90servo_gear-2.SLDPRT

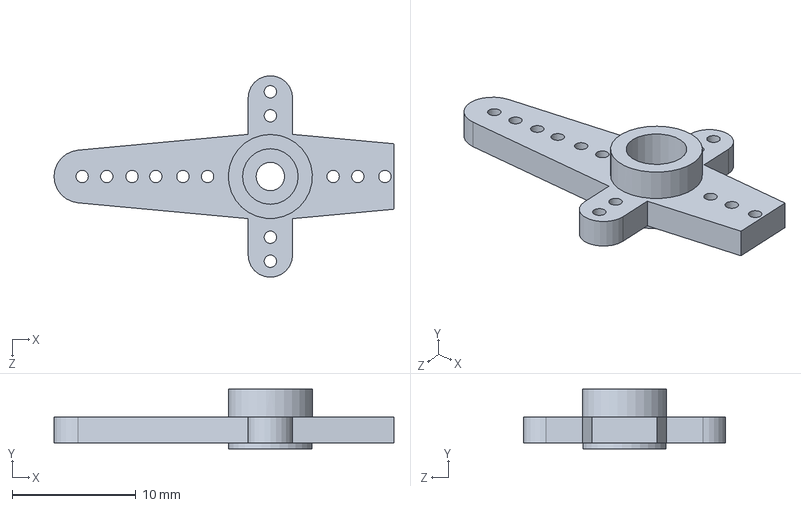
[picture p111: CAD file, 2022-08-04]
1.3D model/Baize_QuadrupedRobot_Allboard/MG90servo_gear-2.SLDPRT
27.5 x 4.85 x 16.3 mm
