Allen953/Baize_Q1mini/1.3D model/Baize_QuadrupedRobot_3.0/cap106C.SLDPRT

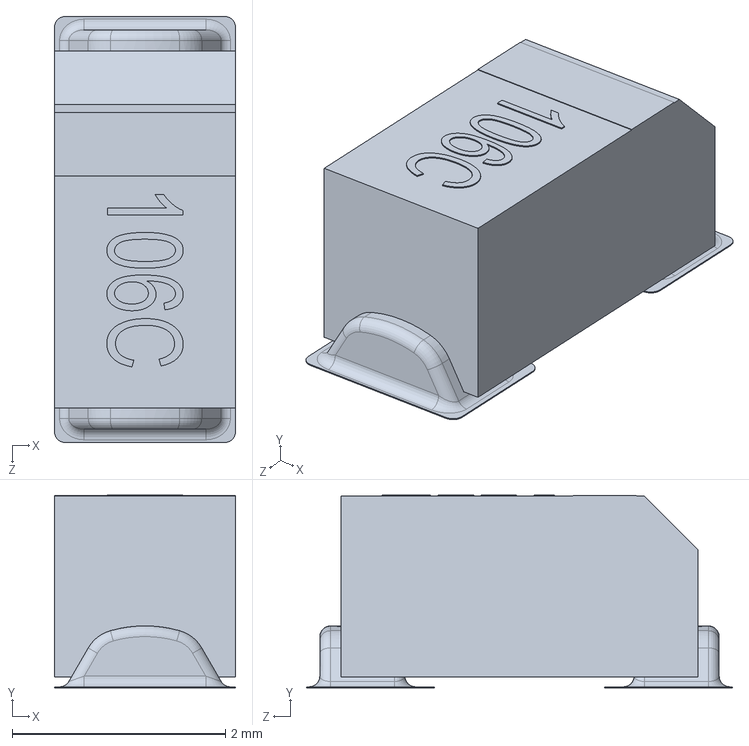
[picture p112: CAD file, 2022-08-04]
1.3D model/Baize_QuadrupedRobot_3.0/cap106C.SLDPRT
1.70 x 1.81 x 4.00 mm
