Allen953/Baize_Q1mini/1.3D model/Baize_QuadrupedRobot_Allboard/Ceban_gou-2.SLDPRT

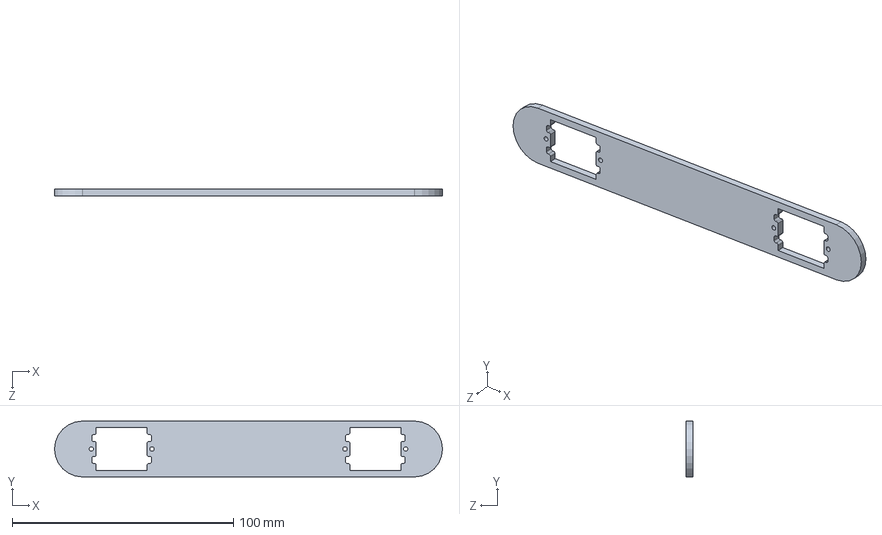
[picture p113: CAD file, 2022-08-04]
1.3D model/Baize_QuadrupedRobot_Allboard/Ceban_gou-2.SLDPRT
175.2 x 25.2 x 3.00 mm
