Allen953/Baize_Q1mini/1.3D model/Baize_QuadrupedRobot_2.8/solidworks2020/led.SLDPRT

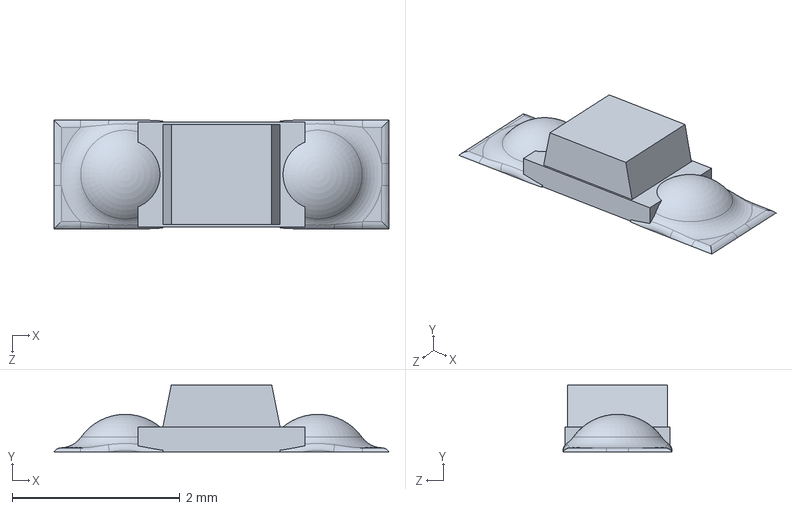
[picture p114: CAD file, 2022-08-04]
1.3D model/Baize_QuadrupedRobot_2.8/solidworks2020/led.SLDPRT
4.00 x 0.8 x 1.30 mm
