Allen953/Baize_Q1mini/1.3D model/Baize_QuadrupedRobot_Allboard/Thigh.SLDPRT

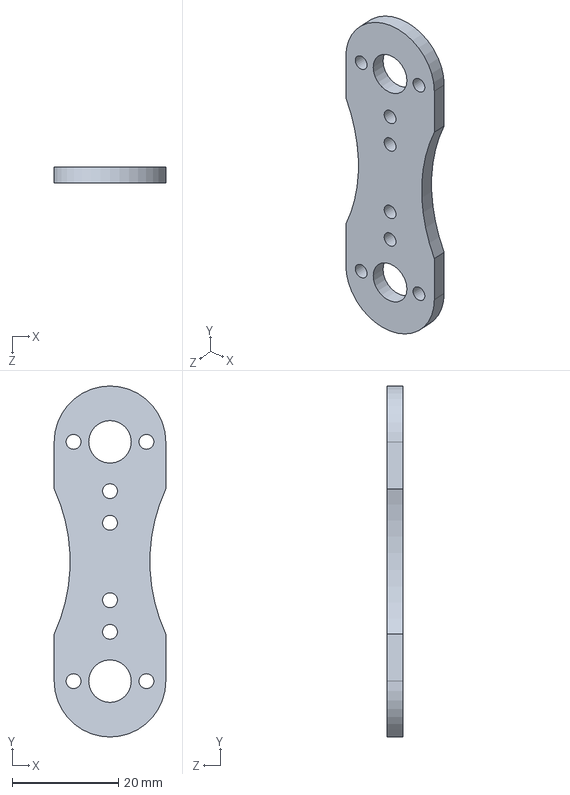
[picture p115: CAD file, 2022-08-04]
1.3D model/Baize_QuadrupedRobot_Allboard/Thigh.SLDPRT
21.0 x 66.0 x 3.00 mm
