Allen953/Baize_Q1mini/1.3D model/Baize_QuadrupedRobot_2.8/solidworks2020/MINI USB CONTACT.SLDPRT

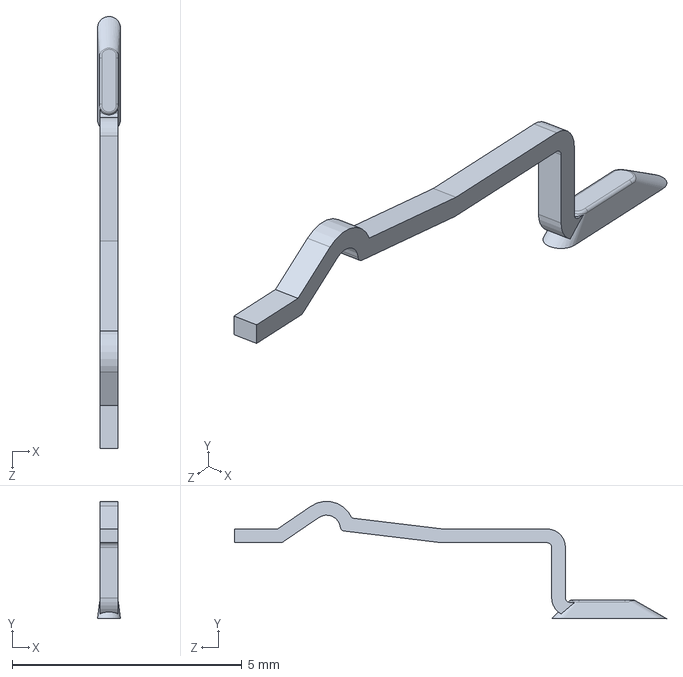
[picture p116: CAD file, 2022-08-04]
1.3D model/Baize_QuadrupedRobot_2.8/solidworks2020/MINI USB CONTACT.SLDPRT
0.5 x 2.55 x 9.40 mm
