Allen953/Baize_Q1mini/1.3D model/Baize_QuadrupedRobot_Allboard/MG90servo_shaft.SLDPRT

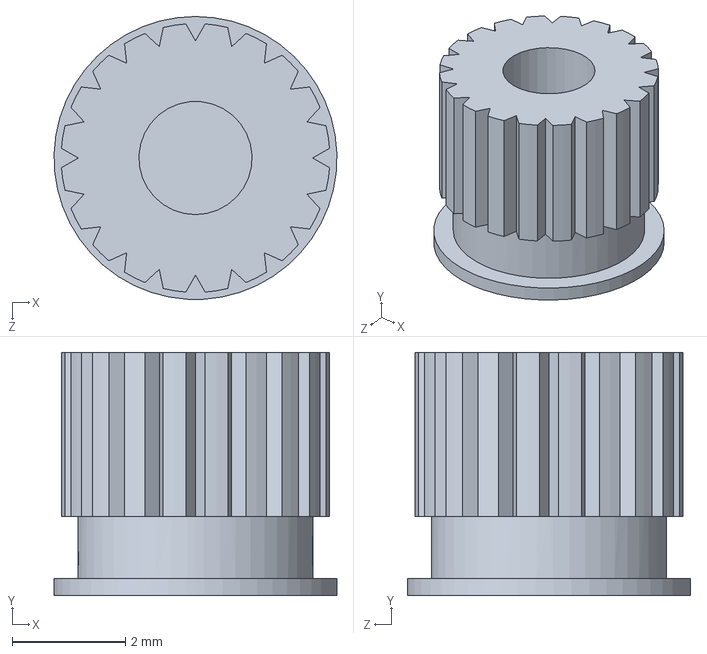
[picture p117: CAD file, 2022-08-04]
1.3D model/Baize_QuadrupedRobot_Allboard/MG90servo_shaft.SLDPRT
5.00 x 4.30 x 5.00 mm
