Allen953/Baize_Q1mini/1.3D model/Baize_QuadrupedRobot_2.8/solidworks2020/Thigh3.SLDPRT

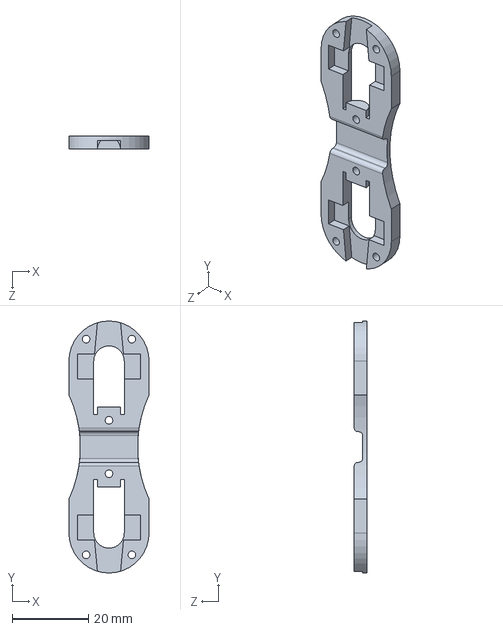
[picture p119: CAD file, 2022-08-04]
1.3D model/Baize_QuadrupedRobot_2.8/solidworks2020/Thigh3.SLDPRT
21.0 x 66.0 x 3.30 mm
