Allen953/Baize_Q1mini/1.3D model/Baize_QuadrupedRobot_3.0/reset shell.SLDPRT

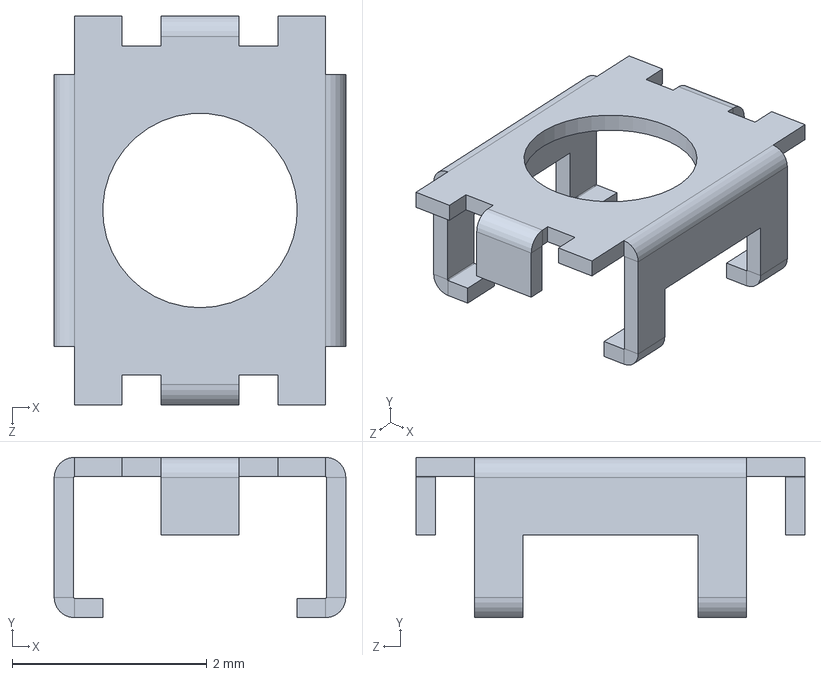
[picture p120: CAD file, 2022-08-04]
1.3D model/Baize_QuadrupedRobot_3.0/reset shell.SLDPRT
3.00 x 1.65 x 4.00 mm
