Allen953/Baize_Q1mini/1.3D model/Baize_QuadrupedRobot_2.8/solidworks2020/Samtec-SSW-115-01-F-S.SLDPRT

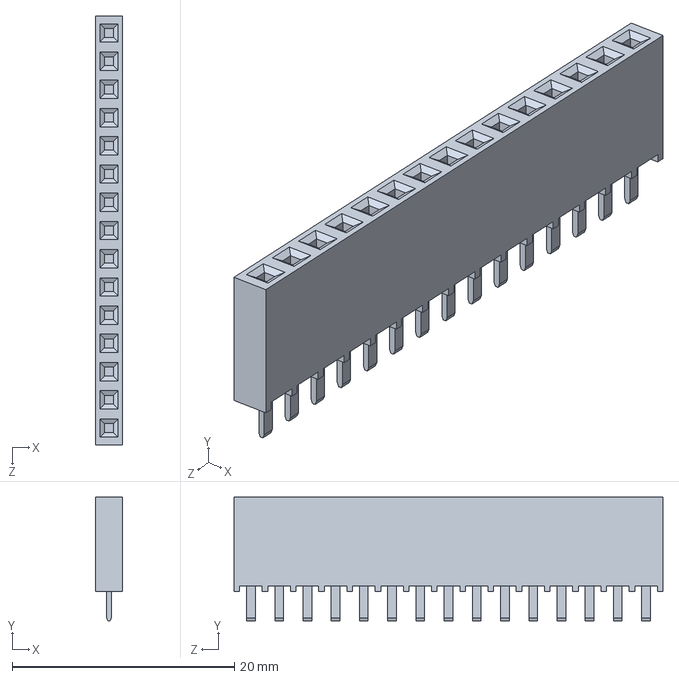
[picture p121: CAD file, 2022-08-04]
1.3D model/Baize_QuadrupedRobot_2.8/solidworks2020/Samtec-SSW-115-01-F-S.SLDPRT
2.41 x 11.2 x 38.6 mm
