Allen953/Baize_Q1mini/1.3D model/Baize_QuadrupedRobot_3.0/Thigh.SLDPRT

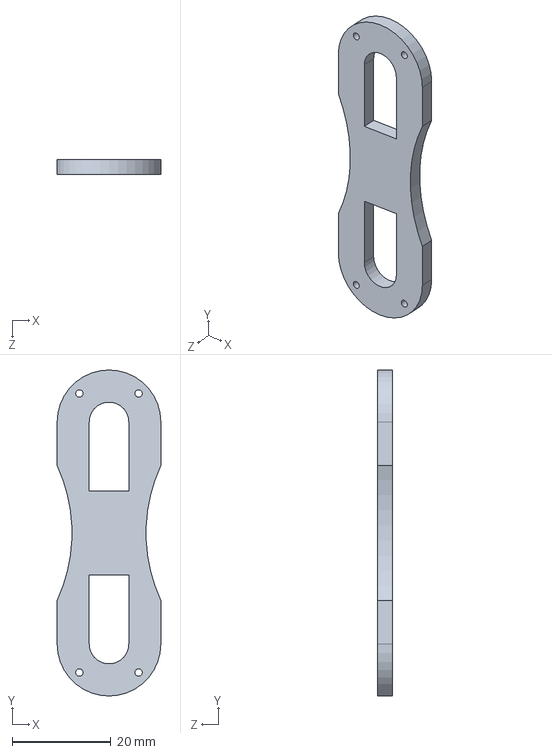
[picture p123: CAD file, 2022-08-04]
1.3D model/Baize_QuadrupedRobot_3.0/Thigh.SLDPRT
21.0 x 66.0 x 3.00 mm
