Allen953/Baize_Q1mini/1.3D model/Baize_QuadrupedRobot_Allboard/SG90 - Micro Servo 9g - Tower Pro.3.SLDPRT

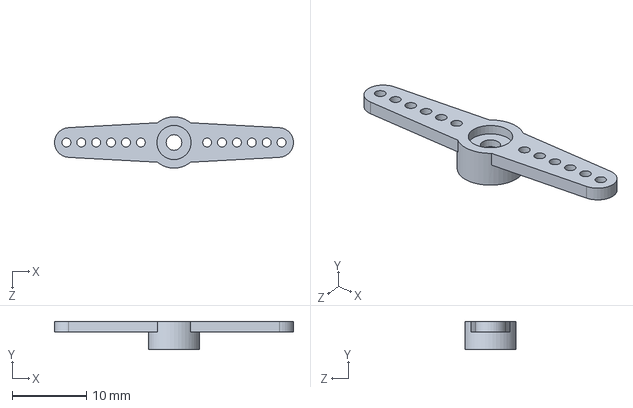
[picture p124: CAD file, 2022-08-04]
1.3D model/Baize_QuadrupedRobot_Allboard/SG90 - Micro Servo 9g - Tower Pro.3.SLDPRT
32.1 x 3.80 x 6.90 mm
