Allen953/Baize_Q1mini/1.3D model/Baize_QuadrupedRobot_2.8/solidworks2020/NANO DIODE.SLDPRT

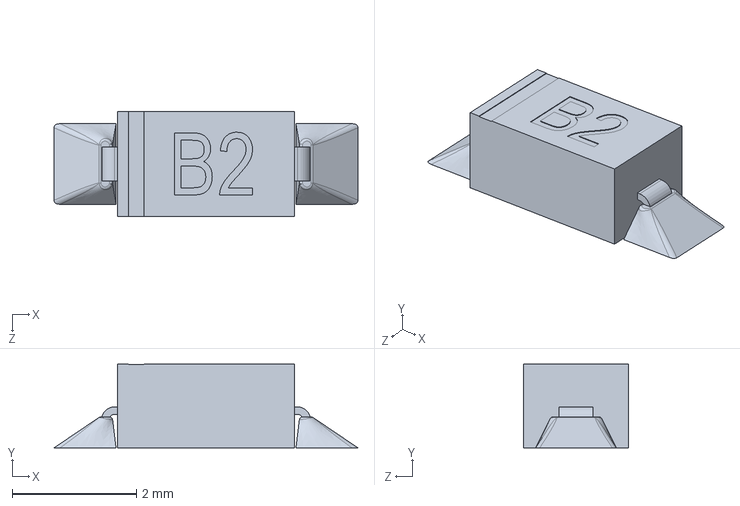
[picture p125: CAD file, 2022-08-04]
1.3D model/Baize_QuadrupedRobot_2.8/solidworks2020/NANO DIODE.SLDPRT
4.90 x 1.35 x 1.70 mm
