Allen953/Baize_Q1mini/1.3D model/Baize_QuadrupedRobot_2.8/solidworks2020/15pin_header__.sldprt

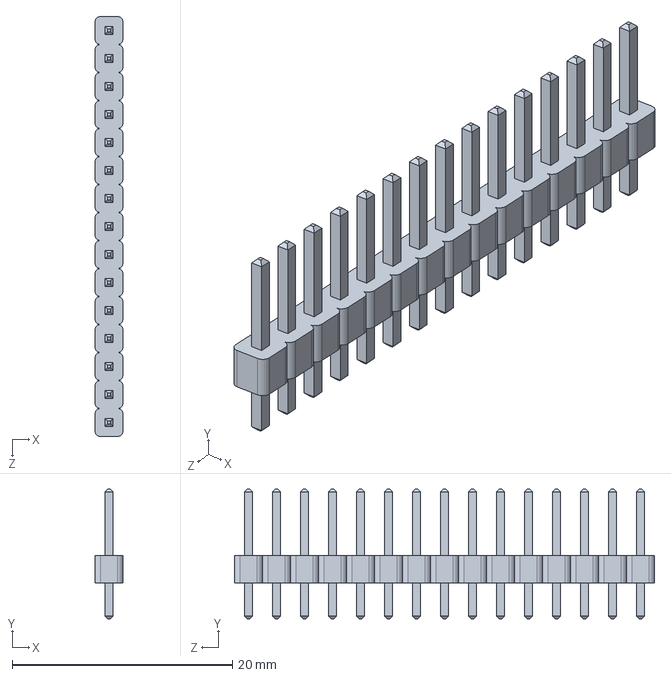
[picture p126: CAD file, 2022-08-04]
1.3D model/Baize_QuadrupedRobot_2.8/solidworks2020/15pin_header__.sldprt
2.54 x 11.8 x 38.1 mm
