Allen953/Baize_Q1mini/1.3D model/Baize_QuadrupedRobot_2.8/solidworks2020/MINIUSBSHELL.SLDPRT

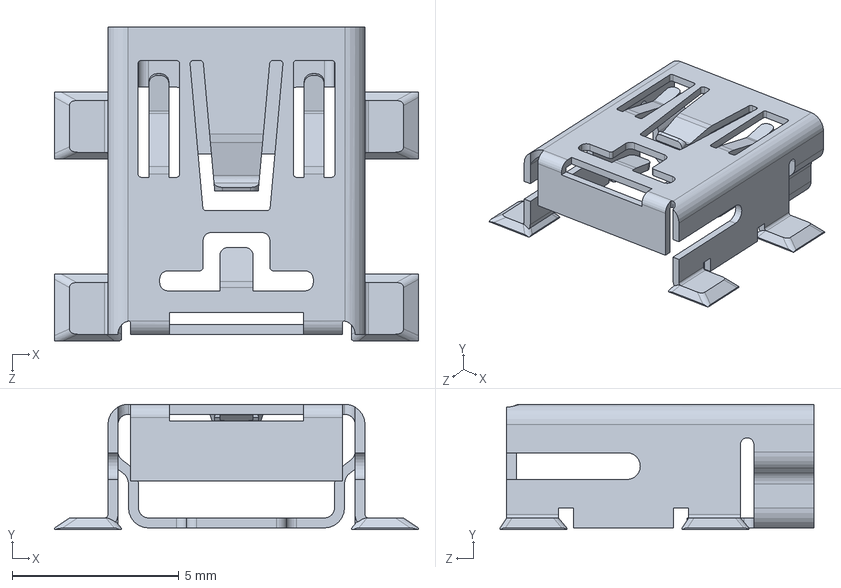
[picture p127: CAD file, 2022-08-04]
1.3D model/Baize_QuadrupedRobot_2.8/solidworks2020/MINIUSBSHELL.SLDPRT
10.9 x 3.75 x 9.40 mm
