Allen953/Baize_Q1mini/1.3D model/Baize_QuadrupedRobot_Allboard/SG90 - Micro Servo 9g - Tower Pro.6.SLDPRT

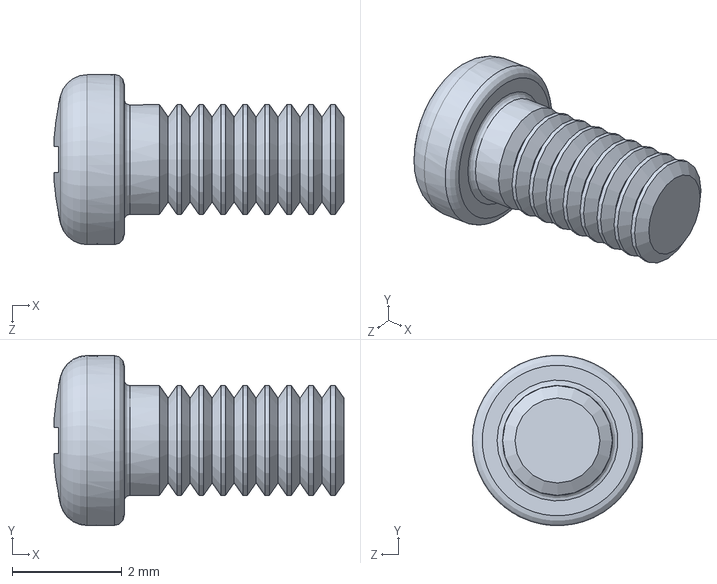
[picture p128: CAD file, 2022-08-04]
1.3D model/Baize_QuadrupedRobot_Allboard/SG90 - Micro Servo 9g - Tower Pro.6.SLDPRT
5.28 x 3.10 x 3.10 mm
