Allen953/Baize_Q1mini/1.3D model/Baize_QuadrupedRobot_2.8/solidworks2020/reset core.SLDPRT

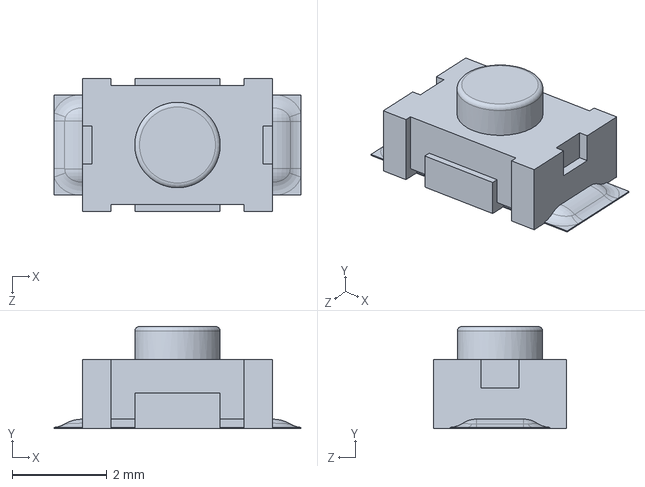
[picture p129: CAD file, 2022-08-04]
1.3D model/Baize_QuadrupedRobot_2.8/solidworks2020/reset core.SLDPRT
5.20 x 2.15 x 2.80 mm
