Allen953/Baize_Q1mini/1.3D model/Baize_QuadrupedRobot_2.8/solidworks2020/2pin_header__02.sldprt

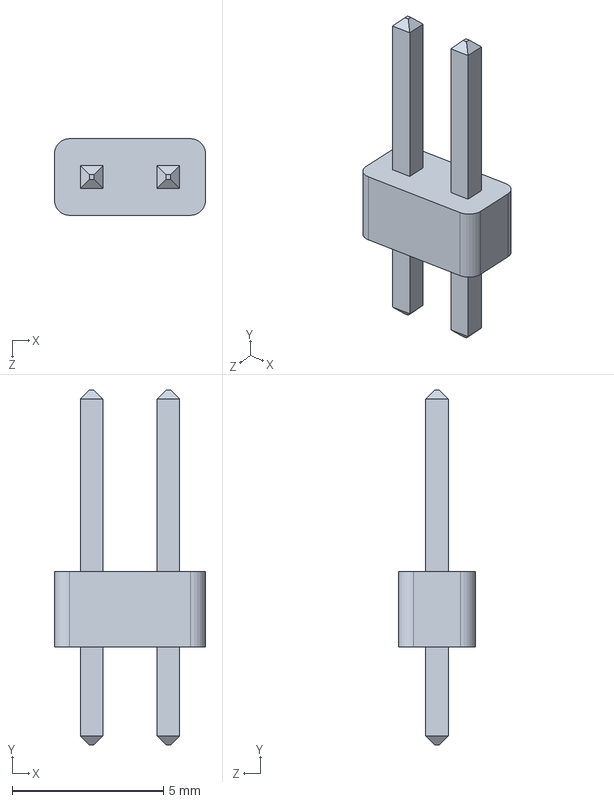
[picture p130: CAD file, 2022-08-04]
1.3D model/Baize_QuadrupedRobot_2.8/solidworks2020/2pin_header__02.sldprt
5.00 x 11.8 x 2.54 mm
