Allen953/Baize_Q1mini/1.3D model/Baize_QuadrupedRobot_Allboard/Shield_Arduino NANO.SLDPRT

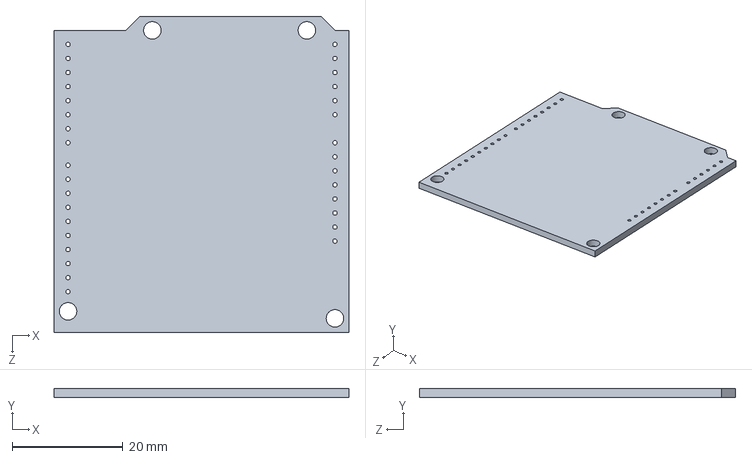
[picture p131: CAD file, 2022-08-04]
1.3D model/Baize_QuadrupedRobot_Allboard/Shield_Arduino NANO.SLDPRT
53.3 x 1.65 x 57.2 mm
