Allen953/Baize_Q1mini/1.3D model/Baize_QuadrupedRobot_3.0/Diban-g-s.SLDPRT

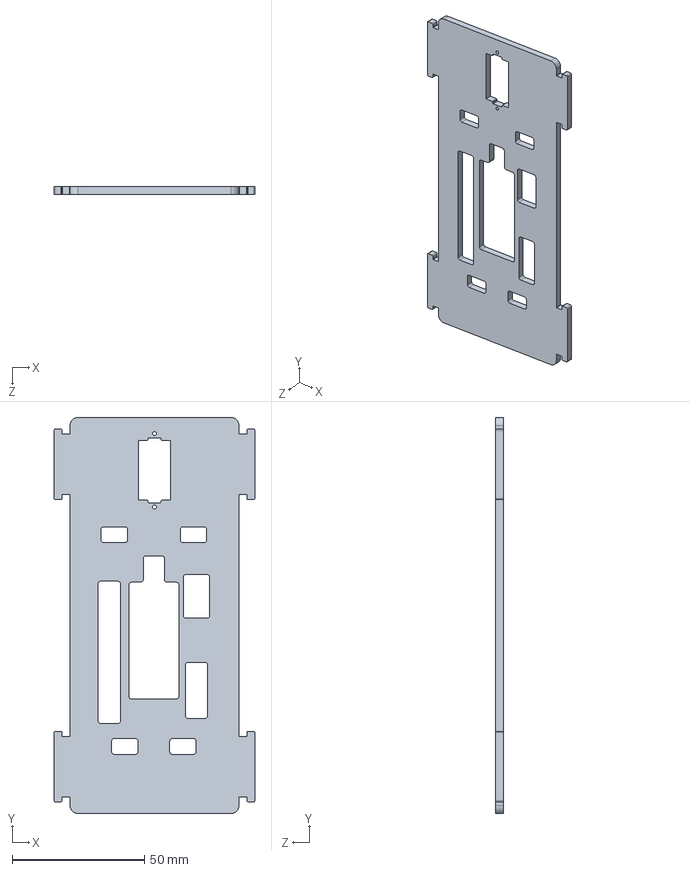
[picture p132: CAD file, 2022-08-04]
1.3D model/Baize_QuadrupedRobot_3.0/Diban-g-s.SLDPRT
76.0 x 150.0 x 3.00 mm
