Allen953/Baize_Q1mini/1.3D model/Baize_QuadrupedRobot_2.8/solidworks2020/MG90servo_gear.SLDPRT

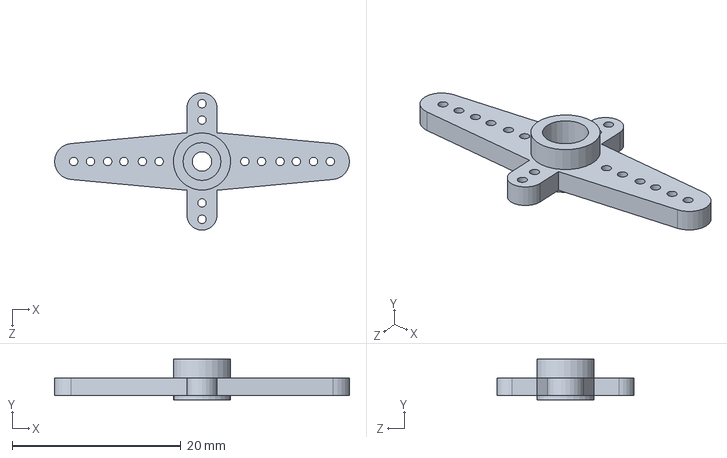
[picture p133: CAD file, 2022-08-04]
1.3D model/Baize_QuadrupedRobot_2.8/solidworks2020/MG90servo_gear.SLDPRT
35.0 x 4.85 x 16.3 mm
