Allen953/Baize_Q1mini/1.3D model/Baize_QuadrupedRobot_Allboard/Diban-g.SLDPRT

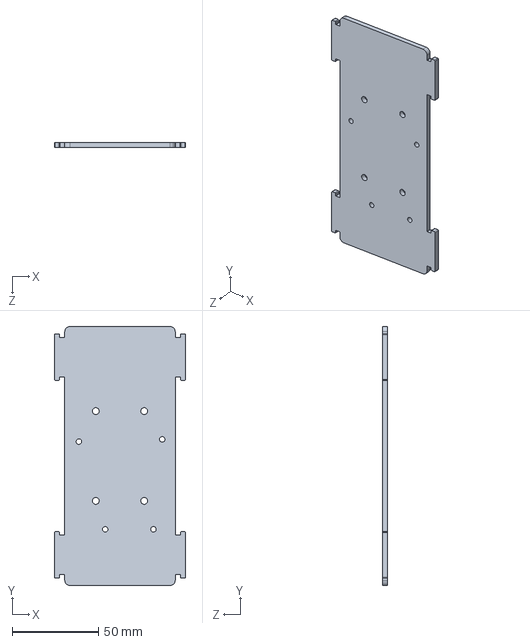
[picture p134: CAD file, 2022-08-04]
1.3D model/Baize_QuadrupedRobot_Allboard/Diban-g.SLDPRT
76.0 x 150.0 x 3.00 mm
