Allen953/Baize_Q1mini/(list of files, cad)

Other CAD files:
1.3D model/Baize_QuadrupedRobot_3.0/User Library-PJ-002AH.sldasm
1.3D model/Baize_QuadrupedRobot_Allboard/SG90 - Micro Servo 9g - Tower Pro.SLDASM
1.3D model/Baize_QuadrupedRobot_3.0/MINIUSB - MEASURED.SLDASM
1.3D model/Baize_QuadrupedRobot_3.0/SG90 - Micro Servo 9g - Tower Pro.SLDASM
1.3D model/Baize_QuadrupedRobot_3.0/Gou-2-Xiaotui.SLDASM
1.3D model/Baize_QuadrupedRobot_2.8/solidworks2020/arduino nano.SLDASM
1.3D model/Baize_QuadrupedRobot_Allboard/MINIUSB - MEASURED.SLDASM
1.3D model/Baize_QuadrupedRobot_Allboard/User Library-PJ-002AH.sldasm
1.3D model/Baize_QuadrupedRobot_2.8/solidworks2020/Gou-2-Datui.SLDASM
1.3D model/Baize_QuadrupedRobot_Allboard/Gou-2-Xiaotui.SLDASM
1.3D model/Baize_QuadrupedRobot_2.8/solidworks2020/Ensamblaje_Shield_NANO.SLDASM
1.3D model/Baize_QuadrupedRobot_2.8/solidworks2020/reset button.SLDASM
1.3D model/Baize_QuadrupedRobot_2.8/cad/zongtu.DWG
1.3D model/Baize_QuadrupedRobot_3.0/QQ_cad/Ceban_gou-2.DWG
1.3D model/Baize_QuadrupedRobot_Allboard/QQ_cad/Thigh.DWG
1.3D model/Baize_QuadrupedRobot_2.8/cad/ceban.DWG
1.3D model/Baize_QuadrupedRobot_3.0/Samtec-TLW-104-01-F-S_B.SLDPRT
1.3D model/Baize_QuadrupedRobot_Allboard/QQ_cad/gou2-xiaotui.DWG
1.3D model/Baize_QuadrupedRobot_2.8/cad/xiaotui.DWG
1.3D model/Baize_QuadrupedRobot_3.0/102 RESISTOR PACK.SLDPRT
1.3D model/Baize_QuadrupedRobot_3.0/QQ_cad/QQ-r - carbon-fibre.dwg
1.3D model/Baize_QuadrupedRobot_Allboard/102 RESISTOR PACK.SLDPRT
1.3D model/Baize_QuadrupedRobot_Allboard/QQ_cad/QQ-r - carbon-fibre.dwg
1.3D model/Baize_QuadrupedRobot_2.8/cad/shangban.DWG
1.3D model/Baize_QuadrupedRobot_3.0/QQ_cad/QQ-r.dwg
1.3D model/Baize_QuadrupedRobot_Allboard/QQ_cad/Diban-g-s.DWG
1.3D model/Baize_QuadrupedRobot_2.8/cad/datui.DWG
1.3D model/Baize_QuadrupedRobot_3.0/QQ_cad/Diban-g-s.DWG
1.3D model/Baize_QuadrupedRobot_Allboard/QQ_cad/QQ-r.dwg
1.3D model/Baize_QuadrupedRobot_2.8/cad/xiaban.DWG
1.3D model/Baize_QuadrupedRobot_3.0/QQ_cad/Thigh.DWG
1.3D model/Baize_QuadrupedRobot_Allboard/QQ_cad/Diban-g.DWG
1.3D model/Baize_QuadrupedRobot_3.0/QQ_cad/Diban-g.DWG
1.3D model/Baize_QuadrupedRobot_Allboard/QQ_cad/Ceban_gou-2.DWG
1.3D model/Baize_QuadrupedRobot_3.0/QQ_cad/gou2-xiaotui.DWG
1.3D model/Baize_QuadrupedRobot_Allboard/QQ_cad/baize-cad.dwg
1.3D model/Baize_QuadrupedRobot_2.8/solidworks2020/47uf CAP Dcase.SLDPRT
1.3D model/Baize_QuadrupedRobot_3.0/Samtec-TLW-108-01-F-S_N.SLDPRT
1.3D model/Baize_QuadrupedRobot_Allboard/Samtec-TLW-108-01-F-S_N.SLDPRT
1.3D model/Baize_QuadrupedRobot_Allboard/blm21.SLDPRT
1.3D model/Baize_QuadrupedRobot_Allboard/atmega328.SLDPRT
1.3D model/Baize_QuadrupedRobot_2.8/solidworks2020/Samtec-TLW-108-01-F-S_N.SLDPRT
1.3D model/Baize_QuadrupedRobot_3.0/Samtec-SSW-115-01-F-S.SLDPRT
1.3D model/Baize_QuadrupedRobot_2.8/solidworks2020/User Library-PJ-002AH_Body.sldprt
1.3D model/Baize_QuadrupedRobot_3.0/Thigh3.SLDPRT
1.3D model/Baize_QuadrupedRobot_Allboard/Thigh3.SLDPRT
1.3D model/Baize_QuadrupedRobot_3.0/User Library-PJ-002AH_Body.sldprt
1.3D model/Baize_QuadrupedRobot_2.8/solidworks2020/SG90 - Micro Servo 9g - Tower Pro.6.SLDPRT
1.3D model/Baize_QuadrupedRobot_Allboard/Samtec-TLW-104-01-F-S_B.SLDPRT
1.3D model/Baize_QuadrupedRobot_3.0/Samtec-TLW-108-01-F-S_R.SLDPRT
1.3D model/Baize_QuadrupedRobot_Allboard/Samtec-TLW-104-01-F-S_W.SLDPRT
1.3D model/Baize_QuadrupedRobot_Allboard/User Library-PJ-002AH_Body.sldprt
1.3D model/Baize_QuadrupedRobot_2.8/solidworks2020/Samtec-TLW-104-01-F-S_R.SLDPRT
1.3D model/Baize_QuadrupedRobot_2.8/solidworks2020/MG90servo_body.SLDPRT
1.3D model/Baize_QuadrupedRobot_3.0/189 RESISTOR PACK.SLDPRT
1.3D model/Baize_QuadrupedRobot_2.8/solidworks2020/MINI USB SOLDER.SLDPRT
1.3D model/Baize_QuadrupedRobot_3.0/Samtec-TLW-104-01-F-S_R.SLDPRT
1.3D model/Baize_QuadrupedRobot_2.8/solidworks2020/Samtec-TLW-104-01-F-S_B.SLDPRT
1.3D model/Baize_QuadrupedRobot_Allboard/Samtec-TLW-104-01-F-S_R.SLDPRT
1.3D model/Baize_QuadrupedRobot_2.8/solidworks2020/16mhz crystal - measured.SLDPRT
1.3D model/Baize_QuadrupedRobot_Allboard/NANO DIODE.SLDPRT
1.3D model/Baize_QuadrupedRobot_3.0/reset core.SLDPRT
1.3D model/Baize_QuadrupedRobot_Allboard/零件.SLDPRT
1.3D model/Baize_QuadrupedRobot_2.8/solidworks2020/Samtec-TLW-104-01-F-S_W.SLDPRT
1.3D model/Baize_QuadrupedRobot_Allboard/2pin_header__02.sldprt
1.3D model/Baize_QuadrupedRobot_2.8/solidworks2020/User Library-PJ-002AH_Pad.sldprt
1.3D model/Baize_QuadrupedRobot_3.0/led.SLDPRT
1.3D model/Baize_QuadrupedRobot_2.8/solidworks2020/Samtec-TLW-103-01-F-S.SLDPRT
1.3D model/Baize_QuadrupedRobot_Allboard/SG90 - Micro Servo 9g - Tower Pro.1.SLDPRT
1.3D model/Baize_QuadrupedRobot_2.8/solidworks2020/Samtec-TLW-104-01-F-S_N.SLDPRT
1.3D model/Baize_QuadrupedRobot_3.0/NANO DIODE.SLDPRT
1.3D model/Baize_QuadrupedRobot_Allboard/User Library-PJ-002AH_Pad.sldprt
1.3D model/Baize_QuadrupedRobot_2.8/solidworks2020/cap106C.SLDPRT
1.3D model/Baize_QuadrupedRobot_3.0/MINIUSBSHELL.SLDPRT
1.3D model/Baize_QuadrupedRobot_Allboard/Samtec-TLW-108-01-F-S_R.SLDPRT
1.3D model/Baize_QuadrupedRobot_2.8/solidworks2020/189 RESISTOR PACK.SLDPRT
1.3D model/Baize_QuadrupedRobot_2.8/solidworks2020/Ceban_gou.SLDPRT
1.3D model/Baize_QuadrupedRobot_2.8/solidworks2020/Diban-g-s.SLDPRT
1.3D model/Baize_QuadrupedRobot_2.8/solidworks2020/Gou-2-xuniguanjie.SLDPRT
1.3D model/Baize_QuadrupedRobot_2.8/solidworks2020/MG90servo_shaft.SLDPRT
1.3D model/Baize_QuadrupedRobot_2.8/solidworks2020/MINIUSBCORE.SLDPRT
1.3D model/Baize_QuadrupedRobot_2.8/solidworks2020/SG90 - Micro Servo 9g - Tower Pro.3.SLDPRT
1.3D model/Baize_QuadrupedRobot_2.8/solidworks2020/SG90 - Micro Servo 9g - Tower Pro.5.SLDPRT
1.3D model/Baize_QuadrupedRobot_2.8/solidworks2020/Samtec-TLW-108-01-F-S_B.SLDPRT
1.3D model/Baize_QuadrupedRobot_2.8/solidworks2020/Samtec-TLW-108-01-F-S_R.SLDPRT
1.3D model/Baize_QuadrupedRobot_2.8/solidworks2020/Shield_Arduino NANO.SLDPRT
1.3D model/Baize_QuadrupedRobot_2.8/solidworks2020/ftdi FT232rl.SLDPRT
1.3D model/Baize_QuadrupedRobot_2.8/solidworks2020/gou2-xiaotui.SLDPRT
1.3D model/Baize_QuadrupedRobot_2.8/solidworks2020/m7 diode.SLDPRT
1.3D model/Baize_QuadrupedRobot_2.8/solidworks2020/nano - reg.SLDPRT
1.3D model/Baize_QuadrupedRobot_2.8/solidworks2020/reset shell.SLDPRT
1.3D model/Baize_QuadrupedRobot_2.8/solidworks2020/smt_resistor222_a.sldprt
1.3D model/Baize_QuadrupedRobot_3.0/15pin_header__.sldprt
1.3D model/Baize_QuadrupedRobot_3.0/2pin_header__02.sldprt
1.3D model/Baize_QuadrupedRobot_3.0/Ceban_gou.SLDPRT
1.3D model/Baize_QuadrupedRobot_3.0/MINI USB CONTACT.SLDPRT
1.3D model/Baize_QuadrupedRobot_3.0/QQ_cad/QQ-r - 副本.dwg
1.3D model/Baize_QuadrupedRobot_3.0/SG90 - Micro Servo 9g - Tower Pro.1.SLDPRT
1.3D model/Baize_QuadrupedRobot_3.0/Samtec-TLW-104-01-F-S_W.SLDPRT
1.3D model/Baize_QuadrupedRobot_3.0/User Library-PJ-002AH_Pad.sldprt
1.3D model/Baize_QuadrupedRobot_3.0/atmega328.SLDPRT
1.3D model/Baize_QuadrupedRobot_3.0/blm21.SLDPRT
1.3D model/Baize_QuadrupedRobot_3.0/ftdi FT232rl.SLDPRT
1.3D model/Baize_QuadrupedRobot_3.0/gou2-xiaotui.SLDPRT
1.3D model/Baize_QuadrupedRobot_3.0/nano - reg.SLDPRT
1.3D model/Baize_QuadrupedRobot_3.0/nano-board.SLDPRT
1.3D model/Baize_QuadrupedRobot_3.0/smt_resistor222_a.sldprt
1.3D model/Baize_QuadrupedRobot_3.0/零件.SLDPRT
1.3D model/Baize_QuadrupedRobot_Allboard/15pin_header__.sldprt
1.3D model/Baize_QuadrupedRobot_Allboard/189 RESISTOR PACK.SLDPRT
1.3D model/Baize_QuadrupedRobot_Allboard/Ceban_gou.SLDPRT
1.3D model/Baize_QuadrupedRobot_Allboard/MINI USB CONTACT.SLDPRT
1.3D model/Baize_QuadrupedRobot_Allboard/MINIUSBSHELL.SLDPRT
1.3D model/Baize_QuadrupedRobot_Allboard/Samtec-SSW-115-01-F-S.SLDPRT
1.3D model/Baize_QuadrupedRobot_Allboard/ftdi FT232rl.SLDPRT
1.3D model/Baize_QuadrupedRobot_Allboard/gou2-xiaotui.SLDPRT
1.3D model/Baize_QuadrupedRobot_Allboard/led.SLDPRT
1.3D model/Baize_QuadrupedRobot_Allboard/nano - reg.SLDPRT
1.3D model/Baize_QuadrupedRobot_Allboard/nano-board.SLDPRT
1.3D model/Baize_QuadrupedRobot_Allboard/reset core.SLDPRT
1.3D model/Baize_QuadrupedRobot_Allboard/smt_resistor222_a.sldprt
