Allen953/Baize_Q1mini/6.Education Files&PPT/PPT/Assembling.pptx

## 机器人与人工智能实验室 Robotics and Artificial Intelligence Laboratory

Exciting Projects in RAIL CUHK-SZ

WELCOME TO

## Tips for Assembling

- 1. The Drive

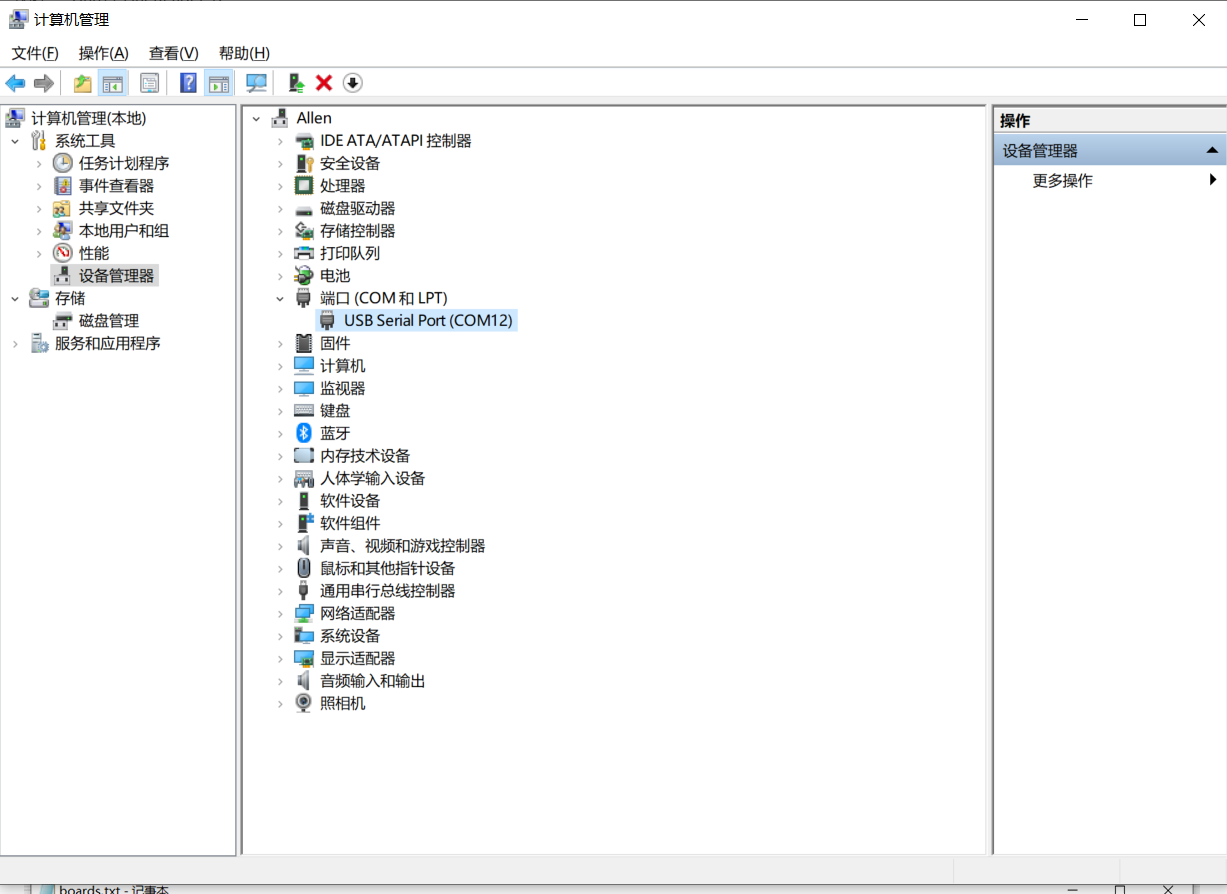
[picture p135: figure]

①

Check the followings:
1. Manage
2. Device Manager
3. Port

②

③

## Tips for Assembling

- The Drive

If you encountered this:

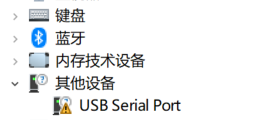
[picture p136: figure]

Or no response like:

Just download and install the drive manually!

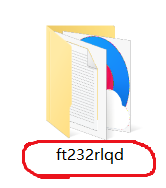
[picture p137: figure]
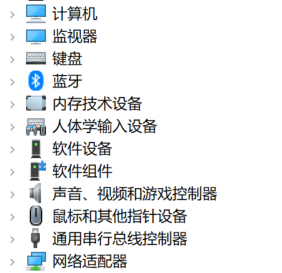
[picture p138: figure]

Click

## Tips for Assembling

- 2. The File board.txt

Replace the former file board.txt by the new one provided.

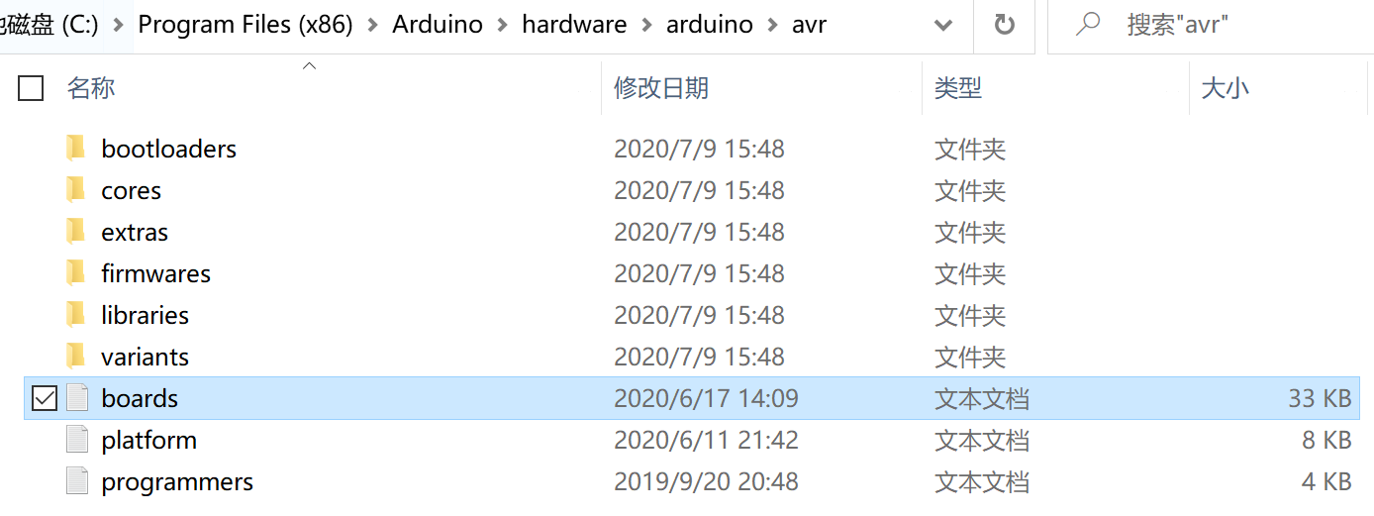
[picture p139: figure]

C:\Program Files (x86)\Arduino\hardware\arduino\avr

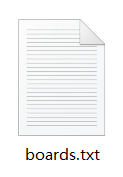
[picture p140: figure]

## Tips for Assembling

- 3. The Pin

Bend the pin of the download port upward with pliers before fixing the Nyboard.

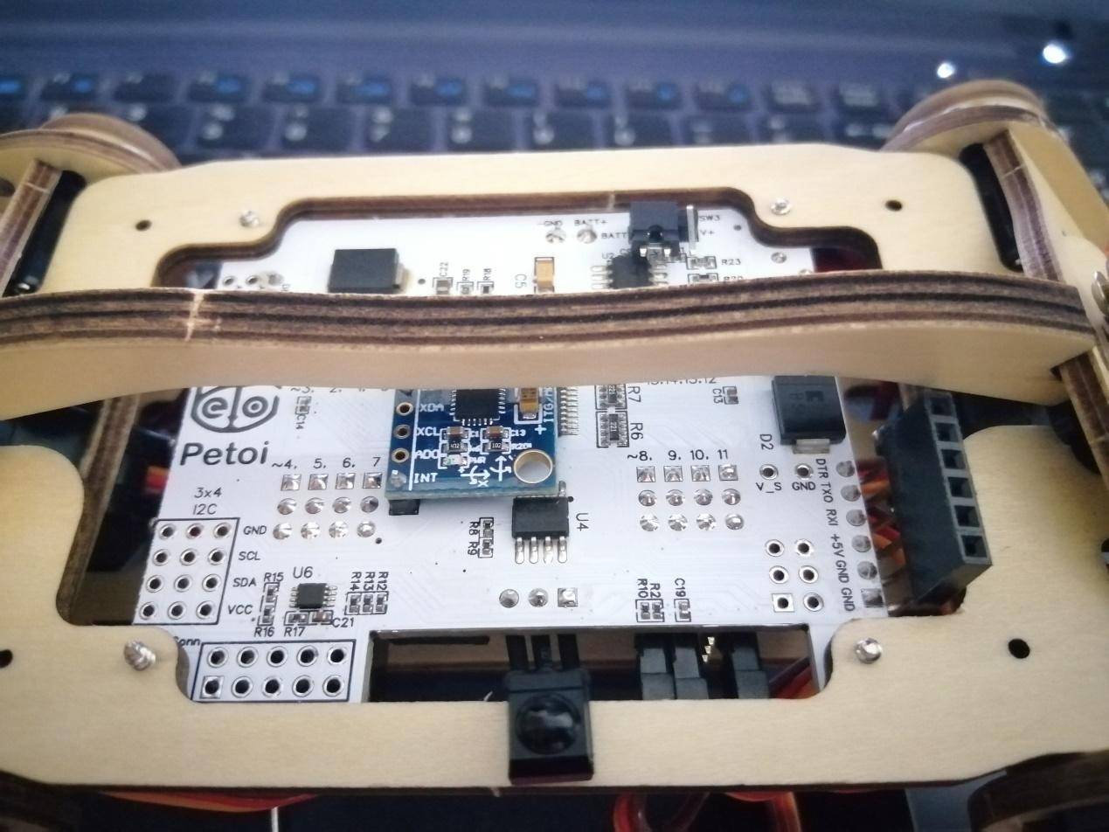
[picture p141: figure]

## Tips for Assembling

- 4. The Version Number

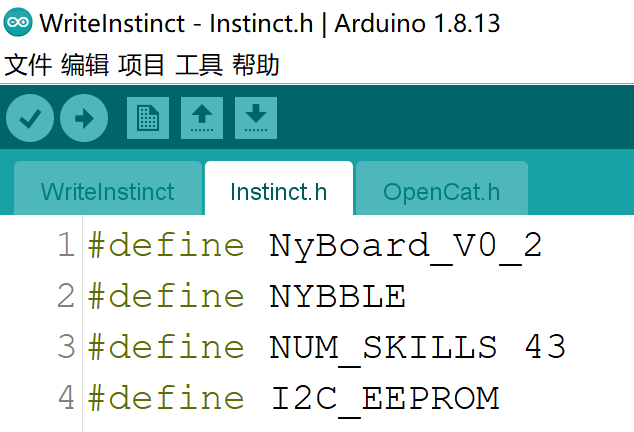
[picture p142: figure]

Revise the version number of Nyboard in file instinct.h with the correct one.

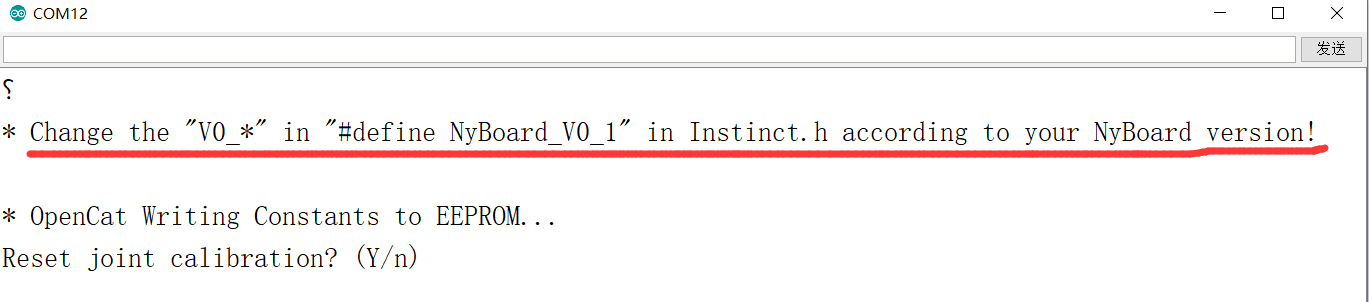
[picture p143: figure]

## Tips for Assembling

- 5. Infrared Remote Control

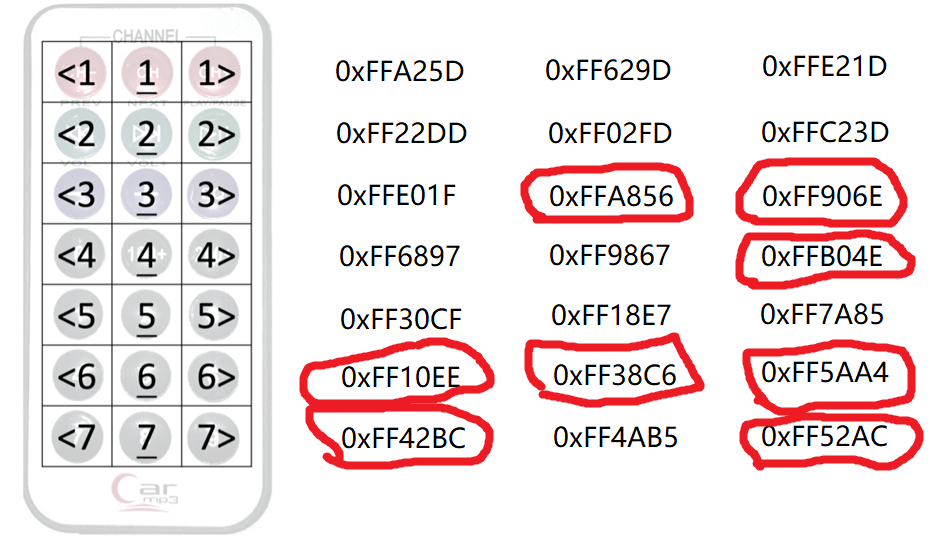
[picture p144: figure]

1. The remote control is used to test the movement of the cat. But there is no response when pressing some of the buttons.
2. Because the values of some buttons in the program are slightly different from the remote control. Therefore, check the values and fill in the correct ones.

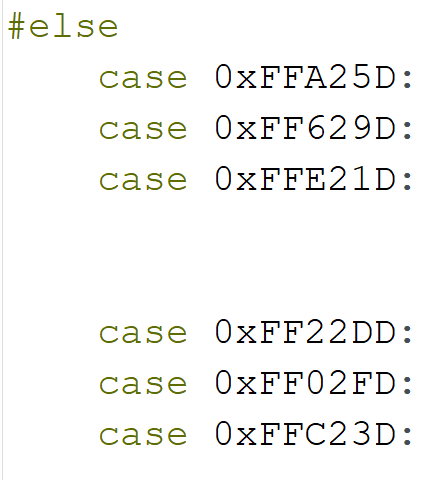
[picture p145: figure]

Edit in file Nybble.ino:

## Tips for Assembling

- 6. Miscellaneous

1. The positive and negative electrodes of the board must be connected correctly to power on, otherwise the components on the board may be burned out! ! !
2. Update your instincts during the first calibration procedure! ! !
3. The button cell of the remote control is not included. Ask the manufacturer for it or buy it yourself.

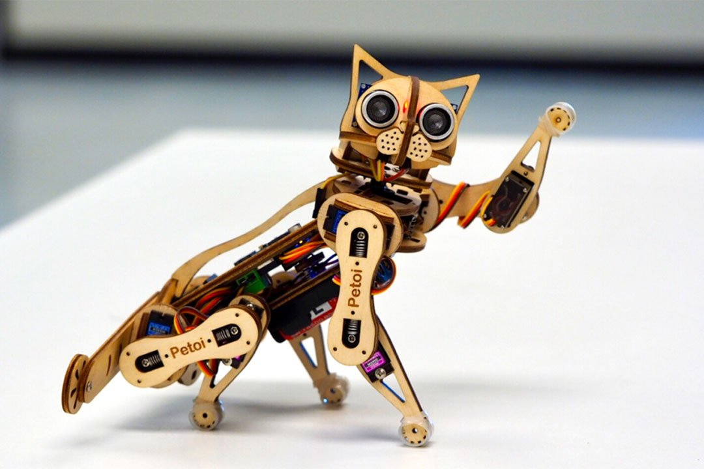
[picture p146: figure]
See the source image

## Tips for Assembling

- Miscellaneous

If we pick “Y”, the joint calibration data will be reset to default. When we calibrate the joint, we must select “n” every time we encounter this problem. Otherwise we will have to recalibrate after resetting.

4. (a) When installing for the first time, do Not tighten the joint screws. Because the steering angle must be calibrated.
(b) It will show a prompt when opening the serial port:

## Tips for Assembling

- Miscellaneous

4. The second question is whether to update the instinct. It needs to be updated when it’s powered on for the first time.
Updating is only needed when new instincts are designed.

## THANK YOU

Teaching Building

- 林天麟 教授
- 香港中文大学（深圳）
- 机器人与人工智能实验室
- WeChat: tinlunlam
