Allen953/Baize_Q1mini/3.Sofrware/QQ_master/baize/baize.ino

#include <Servo.h>
#include <EEPROM.h>  //引入库文件

#define servo_speed 30

Servo myservo[8];
const int servo_pin[8]={6,5,8,9,10,11,12,13};


//数据存储起始位置
#define servo_jz 0



//p为停止，j为校准。k为运动(k:前进;b:后退;l:左转;r:右转）,w为校准状态。
char token="p";
//舵机校准角度
char jz[8]={0,0,0,0,0,0,0,0};

int direct[8]={
  1,-1,-1,1,
  -1,1,1,-1
};
//前进
char wk[43][8]= {
 12, 59,-55,-49, 23, 24, -2,-12,
 15, 59,-63,-47, 22, 27, -8,-11,
 18, 59,-67,-45, 20, 30,-20,-11,
 21, 59,-66,-43, 18, 34,-33,-10,
 24, 59,-64,-40, 16, 38,-37,-10,
 27, 58,-62,-37, 15, 43,-41,-11,
 30, 57,-60,-35, 13, 47,-45,-12,
 32, 58,-57,-32, 13, 47,-48,-13,
 35, 60,-57,-29, 12, 45,-47,-14,
 38, 62,-58,-26, 12, 41,-42,-15,
 40, 65,-59,-23, 11, 36,-37,-16,
 43, 66,-59,-20, 11, 32,-33,-18,
 45, 67,-59,-17, 11, 18,-30,-20,
 47, 62,-59,-14, 11,  7,-26,-22,
 49, 53,-59,-12, 12,  1,-24,-24,
 51, 40,-58,-12, 13,  2,-21,-22,
 52, 26,-57,-12, 14,  7,-19,-20,
 54, 17,-55,-14, 15, 13,-18,-16,
 55, 15,-54,-16, 17, 16,-16,-15,
 57, 13,-53,-23, 18, 19,-15, -9,
 58, 12,-51,-38, 21, 22,-13, -2,
 58, 12,-49,-51, 23, 24,-12, -1,
 59, 13,-47,-60, 26, 23,-11, -6,
 59, 17,-45,-66, 29, 20,-11,-15,
 59, 20,-43,-66, 32, 18,-10,-33,
 59, 23,-41,-65, 37, 17,-10,-35,
 58, 26,-38,-63, 41, 15,-11,-40,
 57, 29,-35,-61, 46, 14,-12,-44,
 58, 32,-33,-58, 47, 13,-13,-47,
 59, 34,-30,-57, 47, 12,-14,-48,
 61, 37,-27,-58, 43, 12,-15,-43,
 64, 40,-24,-59, 38, 11,-16,-38,
 65, 42,-21,-59, 34, 11,-17,-34,
 67, 44,-18,-59, 23, 11,-19,-31,
 64, 46,-15,-59, 10, 11,-21,-27,
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
 67, 49,-42,-59, 23,  8, -8,-31,
 64, 49,-41,-59, 10,  8, -8,-27,
 56, 50,-40,-59,  3,  9, -9,-24,
 45, 51,-40,-58,  1,  9, -8,-22,
 31, 51,-40,-57,  5, 10, -7,-19,
 18, 52,-40,-56, 13, 10, -7,-17,
 16, 53,-41,-55, 15, 10, -6,-16,
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
};
char balance[8]= {30,30,30,30,30,30,30,30};

//读取舵机的偏差角度
void read_servo_jz()
{
  for(int i=0;i<8;i++)
  {
    jz[i]=EEPROM.read(servo_jz+i);
    Serial.print("jz[");Serial.print(i);Serial.print("]=");Serial.print(int(jz[i]));Serial.print(";");
  }
    Serial.println(); 
    Serial.println("read servo_jz_data successfull!");
    
}
//站立姿势
void zhanli()
{
        myservo[0].write(90+(int(balance[0]))*direct[0]+jz[0]);
        myservo[1].write(90+(int(balance[4]))*direct[1]+jz[1]);
        myservo[2].write(90+(int(balance[4]))*direct[1]+jz[2]);
        myservo[3].write(90+(int(balance[0]))*direct[0]+jz[3]);
    
    
    
        myservo[4].write(90+direct[4]*(int(balance[0]))+jz[4]);
        myservo[5].write(90+direct[5]*(int(balance[4]))+jz[5]);
        myservo[6].write(90+direct[5]*(int(balance[4]))+jz[6]);
        myservo[7].write(90+direct[4]*(int(balance[0]))+jz[7]);
}
//校准姿势。
void jiaozhunzhanli()
{
  for(int i=0;i<8;i++)
  {

    myservo[i].write(90+jz[i]);
  }
  delay(5);
}

void setup() {
  // put your setup code here, to run once:
  Serial.begin(57600);
  read_servo_jz();
  for(int i=0;i<8;i++)
  {
    pinMode(servo_pin[i],OUTPUT);
    myservo[i].attach(servo_pin[i]);
    myservo[i].write(90+jz[i]);
  }
  delay(1000);
  token='d';
}

void loop() {
  // put your main code here, to run repeatedly:
  if(Serial.available()>0)
  {
    token=Serial.read();
    Serial.print("receive char:");
    Serial.print(token);
    Serial.println();
  }
  
  if(token=='j')//校准舵机角度
  {
    while(Serial.available()>0)
    {
      int servo_id=Serial.parseInt();
      jz[servo_id]=Serial.read();
      jz[servo_id]=Serial.parseInt();
      EEPROM.write(servo_jz+servo_id,jz[servo_id]);
  
      for(int j=0;j<8;j++)
        myservo[j].write(90+jz[j]);
  
      read_servo_jz();//每次校准一个角度之后打印出来一个角度
    }
    token='w';
  }
  else if(token=='k')
  {
      for(int i=0;i<43;i++)
      {
        myservo[0].write(90+(int(wk[i][0]))*direct[0]+direct[0]*(jz[0]));
        myservo[1].write(90+(int(wk[i][1]))*direct[1]+direct[1]*(jz[1]));
        myservo[2].write(90+(int(wk[i][0]))*direct[2]+direct[2]*(jz[2]));
        myservo[3].write(90+(int(wk[i][1]))*direct[3]+direct[3]*(jz[3]));
    
    
    
        myservo[4].write(90+direct[4]*(int(wk[i][4]))+direct[4]*(jz[4]));
        myservo[5].write(90+direct[5]*(int(wk[i][5]))+direct[5]*(jz[5]));
        myservo[6].write(90+direct[6]*(int(wk[i][4]))+direct[6]*(jz[6]));
        myservo[7].write(90+direct[4]*(int(wk[i][5]))+direct[7]*(jz[7]));

        
        
        //Serial.println(int(wk[i][4]));
        delay(servo_speed);
      }
  }
  else if(token=='b')
  {
    for(int i=0;i<45;i++)
      {
        myservo[0].write(90+(int(bk[i][0]))*direct[0]+direct[0]*(jz[0]));
        myservo[1].write(90+(int(bk[i][1]))*direct[1]+direct[1]*(jz[1]));
        myservo[2].write(90+(int(bk[i][0]))*direct[2]+direct[2]*(jz[2]));
        myservo[3].write(90+(int(bk[i][1]))*direct[3]+direct[3]*(jz[3]));
    
    
    
        myservo[4].write(90+direct[4]*(int(bk[i][4]))+direct[4]*(jz[4]));
        myservo[5].write(90+direct[5]*(int(bk[i][5]))+direct[5]*(jz[5]));
        myservo[6].write(90+direct[6]*(int(bk[i][4]))+direct[6]*(jz[6]));
        myservo[7].write(90+direct[4]*(int(bk[i][5]))+direct[7]*(jz[7]));
        
        //Serial.println(int(bk[i][4]));
        delay(servo_speed);
      }
  }
  else if(token=='l')
  {
    for(int i=0;i<43;i++)
      {
        myservo[0].write(90+(int(wkL[i][0]))*direct[0]+direct[0]*(jz[0]));
        myservo[1].write(90+(int(wkL[i][1]))*direct[1]+direct[1]*(jz[1]));
        myservo[2].write(90+(int(wkL[i][0]))*direct[2]+direct[2]*(jz[2]));
        myservo[3].write(90+(int(wkL[i][1]))*direct[3]+direct[3]*(jz[3]));
    
    
    
        myservo[4].write(90+direct[4]*(int(wkL[i][4]))+direct[4]*(jz[4]));
        myservo[5].write(90+direct[5]*(int(wkL[i][5]))+direct[5]*(jz[5]));
        myservo[6].write(90+direct[6]*(int(wkL[i][4]))+direct[6]*(jz[6]));
        myservo[7].write(90+direct[4]*(int(wkL[i][5]))+direct[7]*(jz[7]));
        
        //Serial.println(int(bk[i][4]));
        delay(servo_speed);
      }
  }
  else if(token=='r')
  {
    for(int i=0;i<43;i++)
      {
        myservo[0].write(90+(int(wkR[i][0]))*direct[0]+direct[0]*(jz[0]));
        myservo[1].write(90+(int(wkR[i][1]))*direct[1]+direct[1]*(jz[1]));
        myservo[2].write(90+(int(wkR[i][0]))*direct[2]+direct[2]*(jz[2]));
        myservo[3].write(90+(int(wkR[i][1]))*direct[3]+direct[3]*(jz[3]));
    
    
    
        myservo[4].write(90+direct[4]*(int(wkR[i][4]))+direct[4]*(jz[4]));
        myservo[5].write(90+direct[5]*(int(wkR[i][5]))+direct[5]*(jz[5]));
        myservo[6].write(90+direct[6]*(int(wkR[i][4]))+direct[6]*(jz[6]));
        myservo[7].write(90+direct[4]*(int(wkR[i][5]))+direct[7]*(jz[7]));
        
        //Serial.println(int(bk[i][4]));
        delay(servo_speed);
      }
  }
  else if(token=='d')
    zhanli();
  else if(token=='w')
    jiaozhunzhanli();
  else;
    
  
  
}
