Allen953/Baize_Q1mini/3.Sofrware/Mixly Modified/(1)/RGB-shanshuo/RGB-shanshuo.ino

void setup() {
  // put your setup code here, to run once:
  pinMode(8,OUTPUT);
  pinMode(9,OUTPUT);
}

void loop() {
  // put your main code here, to run repeatedly:
  digitalWrite(8,HIGH);//打开灯光
  digitalWrite(9,HIGH);
  delay(500);
  digitalWrite(8,LOW);//关闭灯光
  digitalWrite(9,LOW);
  delay(500);
}
