Allen953/Baize_Q1mini/3.Sofrware/Demo/(b)/beep_playMelody_meow/Instinct.h

#define NyBoard_V0_2
#define NYBBLE
#define NUM_SKILLS 46
#define I2C_EEPROM
//这里可以想一下为什么角度数据保存的时候要用char类型定义，角度是个数字，为什么要转换成字符呢？
//这里是考虑省内存的原因，int整形是2个字节，byte类型虽然是一个字节但没有负值。
//而我们用到的角度数据范围不大，从-90到90。范围不大，
//而char类型刚好是-128到127.既满足范围，又占用更少内存。eeprom里面一次也只能存储一个字节
const char bd[] PROGMEM = { 
30, 0, 0,
 39, 39,-80,-80, 20, 20, 47, 47,
 29, 29,-73,-73, 24, 24, 48, 48,
 25, 25,-64,-64, 25, 25, 46, 46,
 23, 23,-55,-55, 24, 24, 43, 43,
 22, 22,-47,-47, 20, 20, 38, 38,
 21, 21,-41,-41, 15, 15, 32, 32,
 22, 22,-35,-35,  8,  8, 25, 25,
 24, 24,-31,-31,  0,  0, 19, 19,
 26, 26,-28,-28, -8, -8, 11, 11,
 29, 29,-25,-25,-15,-15,  3,  3,
 33, 33,-24,-24,-23,-23, -4, -4,
 38, 38,-23,-23,-30,-30,-10,-10,
 44, 44,-24,-24,-36,-36,-15,-15,
 52, 52,-26,-26,-42,-42,-18,-18,
 60, 60,-30,-30,-45,-45,-18,-18,
 68, 68,-36,-36,-47,-47,-21,-21,
 77, 77,-40,-40,-47,-47,-25,-25,
 84, 84,-43,-43,-46,-46,-25,-25,
 87, 87,-48,-48,-42,-42,-22,-22,
 89, 89,-54,-54,-37,-37,-17,-17,
 88, 88,-60,-60,-30,-30,-12,-12,
 85, 85,-66,-66,-24,-24, -5, -5,
 81, 81,-72,-72,-16,-16,  3,  3,
 76, 76,-78,-78, -8, -8, 11, 11,
 70, 70,-82,-82, -1, -1, 19, 19,
 64, 64,-86,-86,  5,  5, 26, 26,
 58, 58,-88,-88, 12, 12, 32, 32,
 52, 52,-89,-89, 16, 16, 39, 39,
 47, 47,-87,-87, 18, 18, 43, 43,
 41, 41,-82,-82, 19, 19, 46, 46,
};
//后退步态

const char bk[] PROGMEM = { 
45, 0, 0,
 30, 39,-57,-64,  6, -9, -6,  9,
 28, 49,-58,-56,  7,-11, -7, 11,
 25, 58,-59,-47,  9,-10, -9, 11,
 23, 65,-60,-37, 10, -8,-10,  8,
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
 64, 47,-43,-59, 38,  8, -8,-38,
 65, 48,-43,-59, 34,  8, -8,-34,
 67, 49,-42,-59, 23,  8, -8,-31,
 64, 49,-41,-59, 10,  8, -8,-27,
 56, 50,-40,-59,  3,  9, -9,-24,
 45, 51,-40,-58,  1,  9, -8,-22,
 31, 51,-40,-57,  5, 10, -7,-19,
 18, 52,-40,-56, 13, 10, -7,-17,
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
};

const char balance[] PROGMEM = { 
1, 0, 0,
  0,  0,  0,  0,  0,  0,  0,  0, 30, 30,-30,-30, 30, 30,-30,-30,};
const char buttUp[] PROGMEM = { 
1, 0, -15,
 20, 40,  0,  0,  5,  5,  3,  3, 90, 90,-45,-45,-60,-60, -5, -5,};
const char calib[] PROGMEM = { 
1, 0, 0,
  0,  0,  0,  0,  0,  0,  0,  0,  0,  0,  0,  0,  0,  0,  0,  0,};
const char cd1[] PROGMEM = { 
1, -15, -15,
 20,-45, 30,  0,  5,  5,  3,  3, 70, 70,-45,-45,-60,-60,  0,  0,};
const char cd2[] PROGMEM = { 
1, 15, -15,
-30,-30,  0,  0,  5,  5,  3,  3, 70, 70,-45,-45,-60,-60,  0,  0,};
const char dropped[] PROGMEM = { 
1, 0, -75,
  0, 30,  0,  0, -5, -5, 15, 15,-75,-75,-60,-60, 60, 60, 30, 30,};
const char hi[] PROGMEM = { 
1, 0, 30,
 35, -5,-60,  0, -3, -3,  3,  3,-75, 30,-60,-70, 40, 75, 45,  0,};
const char hi2[] PROGMEM = { 
1, 0, 30,
 40,  0,-35,  0, -3, -3,  3,  3,-60, 30,-60,-70, 60, 75, 45,  0,};
const char lifted[] PROGMEM = { 
1, 0, 75,
  0,-70,  0,  0,  0,  0,  0,  0, 55, 55, 20, 20, 45, 45,  0,  0,};
const char pee[] PROGMEM = { 
1, 0, 0,
 45, 20,  0,  0, 15,-10, 60,-10, 45, 45,-70,-15, 15, 45, 30,-20,};
const char pee1[] PROGMEM = { 
1, 0, 0,
 45, 10,  0,  0, 15,-10, -5, -5, 45, 30,-30,-15, 15, 45,-30,  0,};
const char pu1[] PROGMEM = { 
1, 0, 0,
  0,-30,  0,  0,  0,  0,  0,  0, 20, 20, 60, 60, 60, 60,-55,-55,};
const char pu2[] PROGMEM = { 
1, 0, 0,
  0, 10,  0,  0,  0,  0,  0,  0, 60, 60, 40, 40,-45,-45,-55,-55,};
const char rc1[] PROGMEM = { 
1, 0, 0,
  0,-80,  0,  0,  0,  0,  0,  0, 60, 60, 60, 60,-45,-45,-45,-45,};
const char rc10[] PROGMEM = { 
1, 0, 0,
 45,-80,  0,  0,  0,  0,  0,  0,-80, 15,-15, 70, 60, 60,-55,  0,};
const char rc2[] PROGMEM = { 
1, 0, 0,
  0, 20,  0,  0,  0,  0,  0,  0, 60, 60, 60, 65, 60, 60,-55,-55,};
const char rc3[] PROGMEM = { 
1, 0, 0,
-60, 20,  0,  0,  0,  0,  0,  0, 15, 15,-15,-15, 60, 60,-55,-55,};
const char rc4[] PROGMEM = { 
1, 0, 0,
-60, 50,  0,  0,  0,  0,  0,  0, 15, 15,-15,-15, 60, 60,-55,-55,};
const char rc5[] PROGMEM = { 
1, 0, 0,
 50, 50,  0,  0,  0,  0,  0,  0, 15, 15,-15,-15, 60, 60,-55,-65,};
const char rc6[] PROGMEM = { 
1, 0, 0,
 50, 20,  0,  0,  0,  0,  0,  0,-80, 15,-15, 70, 60, 60,-55,-65,};
const char rc7[] PROGMEM = { 
1, 0, 0,
 45,-80,  0,  0,  0,  0,  0,  0,-80, 60, 60, 70, 60, 60,-55,-65,};
const char rc8[] PROGMEM = { 
1, 0, 0,
 45,-80,-35,  0,  0,  0,  0,  0,-80, 15,-15, 70, 60,-60, 55,-65,};
const char rc9[] PROGMEM = { 
1, 0, 0,
 45,-80,-70,  0,  0,  0,  0,  0,-80, 15,-15, 70, 60, 60,-55,  0,};
const char rest[] PROGMEM = { 
1, 0, 0,
-30,-80,-45,  0, -3, -3,  3,  3, 60, 60,-60,-60,-45,-45, 45, 45,};
const char sit[] PROGMEM = { 
1, 0, 30,
  0,-20,-60,  0, -5, -5, 20, 20, 30, 30,-90,-90, 60, 60, 45, 45,};
const char sleep[] PROGMEM = { 
1, 0, 0,
-10,-100,  0,  0, -5, -5,  3,  3, 80, 80,-80,-80,-55,-55, 55, 55,};
const char str[] PROGMEM = { 
1, 0, 15,
  0, 30,  0,  0, -5, -5,  0,  0,-60,-60,-15,-15, 60, 60,-45,-45,};
const char zero[] PROGMEM = { 
1, 0, 0,
  0,  0,  0,  0,  0,  0,  0,  0,  0,  0,  0,  0,  0,  0,  0,  0,};
  
const char shualai1[] PROGMEM = { 
1, 0, 0,
  0,0,0,0,0,0,0,0,-80,-80,80,80,80,80,-80,-80,};

const char shualai2[] PROGMEM = { 
1, 0, 0,
  -30,-30,0,0,0,0,0,0,-90,-80,90,80,60,80,-60,-80,};

const char shualai3[] PROGMEM = { 
1, 0, 0,
  30,-30,0,0,0,0,0,0,-80,-90,80,90,80,60,-80,-60,};
  
#if !defined(MAIN_SKETCH) || !defined(I2C_EEPROM)
		//if it's not the main sketch to save data or there's no external EEPROM, 
		//the list should always contain all information.
  const char* skillNameWithType[]={"bdI","bkI","bkLI","bkRI","crI","crLI","crRI","lyI","trI","trLI","trRI","vtI","wkI","wkLI","wkRI","balanceI","buttUpI","calibI","cd1I","cd2I","droppedI","hiI","hi2I","liftedI","peeI","pee1I","pu1I","pu2I","rc1I","rc10I","rc2I","rc3I","rc4I","rc5I","rc6I","rc7I","rc8I","rc9I","restI","sitI","sleepI","strI","zeroI","shualai1I","shualai2I","shualai3I",};
  const char* progmemPointer[] = {bd, bk, bkL, bkR, cr, crL, crR, ly, tr, trL, trR, vt, wk, wkL, wkR, balance, buttUp, calib, cd1, cd2, dropped, hi, hi2, lifted, pee, pee1, pu1, pu2, rc1, rc10, rc2, rc3, rc4, rc5, rc6, rc7, rc8, rc9, rest, sit, sleep, str, zero,shualai1,shualai2,shualai3, };
#else	//only need to know the pointers to newbilities, because the intuitions have been saved onto external EEPROM,
	//while the newbilities on progmem are assigned to new addresses
  const char* progmemPointer[] = {};
#endif
//the total byte of instincts is 4473
//the maximal array size is 364 bytes of bk. 
//Make sure to leave enough memory for SRAM to work properly. Any single skill should be smaller than 400 bytes for safety.
