Allen953/Baize_Q1mini/3.Sofrware/Demo/(b)/beep_playMelody_meow/beep_playMelody_meow.ino

#include "OpenCat.h"

void setup() {
  // put your setup code here, to run once:

}

void loop() {
  // put your main code here, to run repeatedly:
  beep(50,100);
  delay(1000);
  beep(50);
  delay(1000);
}
